robertwa1974/evScout--dash/enclosure/scout_dash_cutout_template.pdf

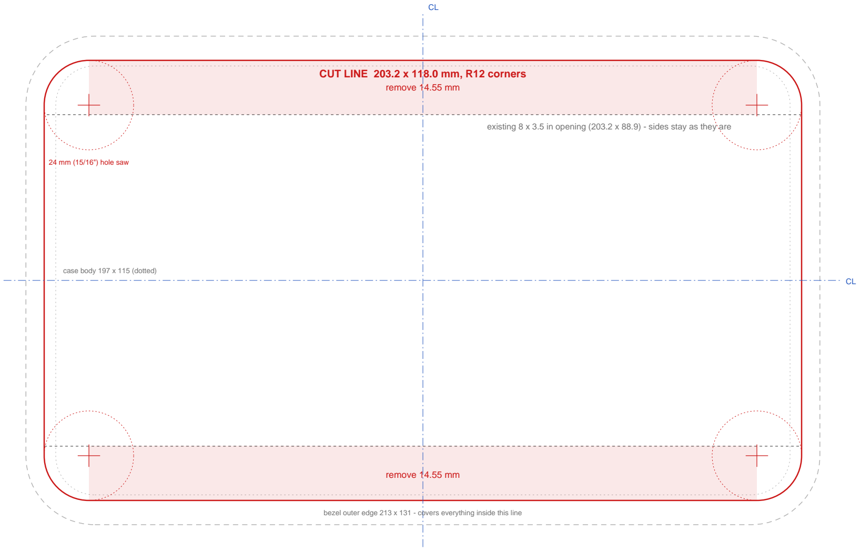
[picture p1: figure]
24 mm (15/16") hole saw; CUT LINE 203.2 x 118.0 mm, R12 corners remove 14.55 mm; remove 14.55 mm; case body 197 x 115 (dotted)

existing 8 x 3.5 in opening (203.2 x 88.9) - sides stay as they are

bezel outer edge 213 x 131 - covers everything inside this line

100 mm - measure this before cutting

4 in

# Scout 80 dash - Waveshare 7" cut-out template

PRINT AT 100% / ACTUAL SIZE (no 'fit to page'). Check both scale bars before cutting.

1 Tape the template to the dash face. Line up the grey dashed box with the existing opening edges. 2 Centre-punch the four + marks and cut the corners with a 24 mm (15/16") hole saw. 3 Cut straight between the holes along the red line, top and bottom only. File to the line and deburr. 4 Test-fit the case: it should slide in with ~3 mm side play and ~1.5 mm top/bottom; the bezel hides the gap.

Assumes the new opening is centred vertically on the existing one. Shift the template if you want it elsewhere.
