robertwa1974/evScout--dash/enclosure/box_v7_view.png

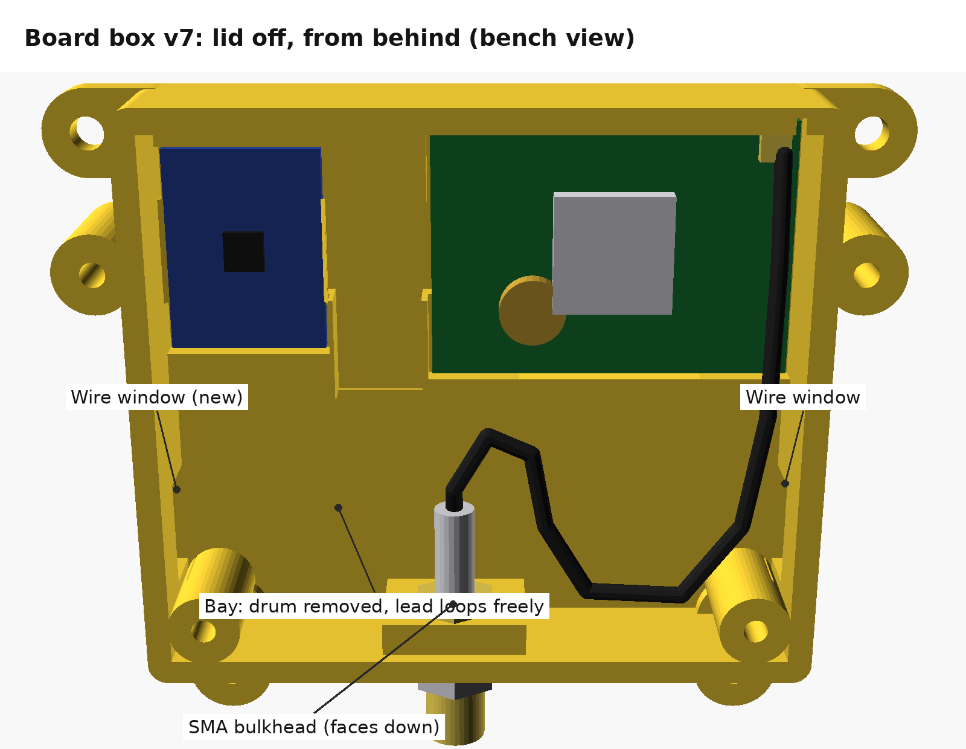
enclosure/box_v7_view.png
