robertwa1974/evScout--dash/enclosure/box_v8_view.png

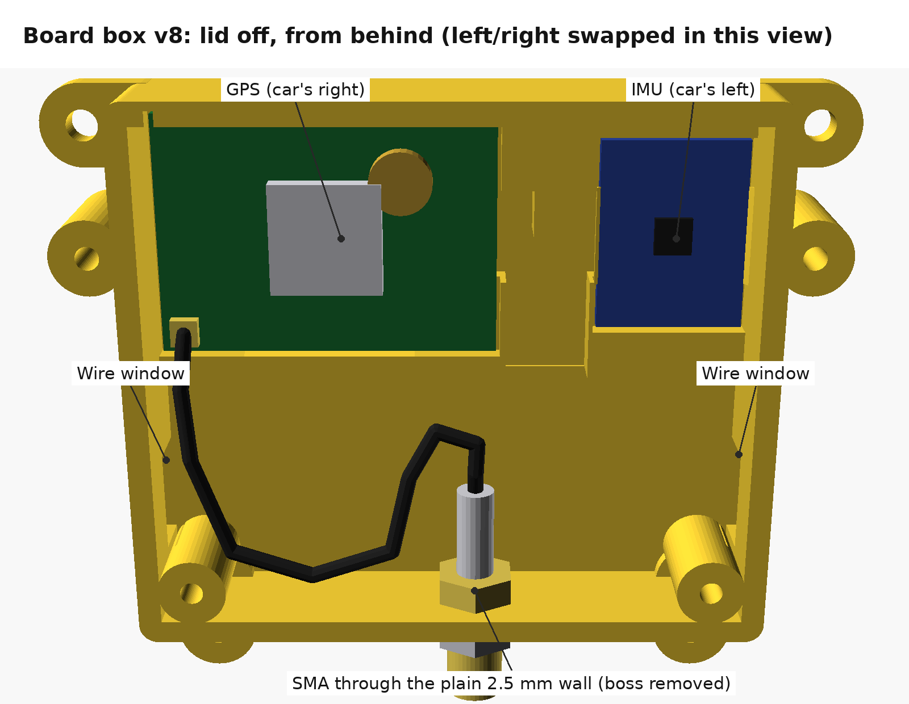
enclosure/box_v8_view.png
