robertwa1974/evScout--dash/enclosure/enclosure_views.png

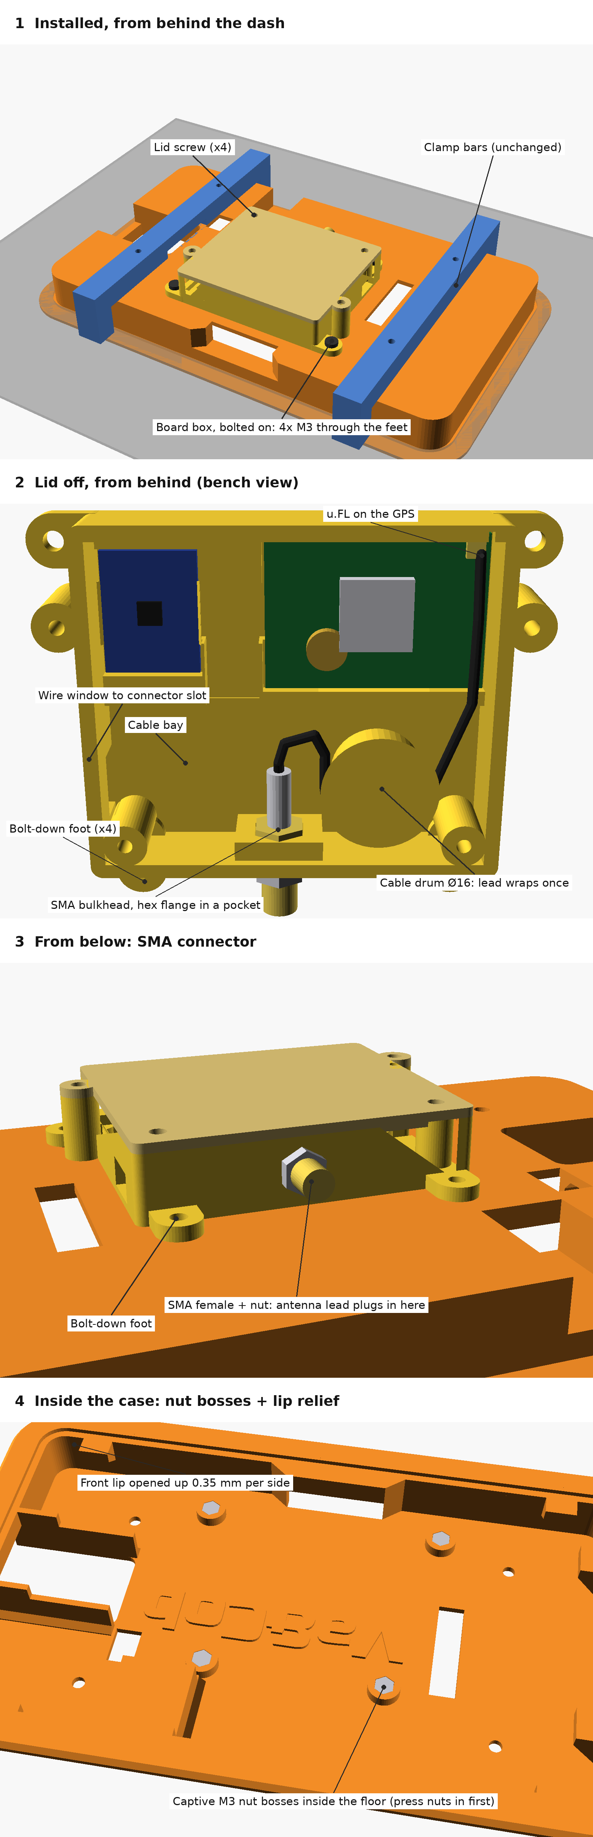
enclosure/enclosure_views.png
