robertwa1974/evScout--dash/enclosure/preview.png

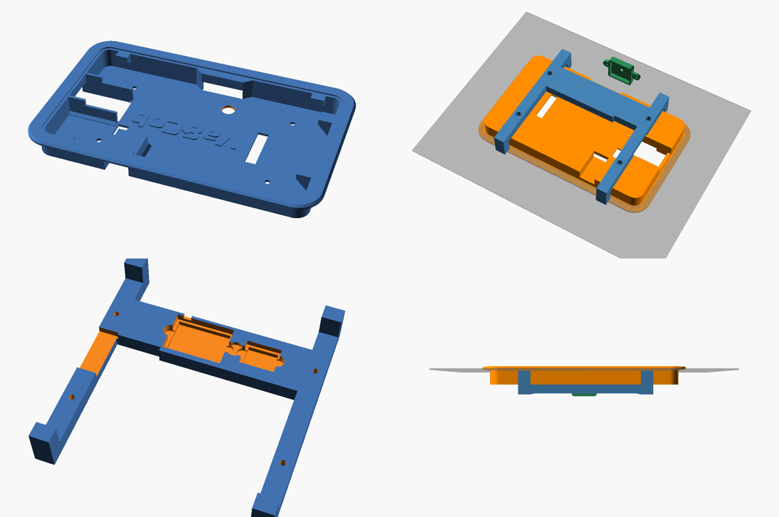
enclosure/preview.png
