robertwa1974/evScout--dash/firmware/assets/incline_art_preview.png

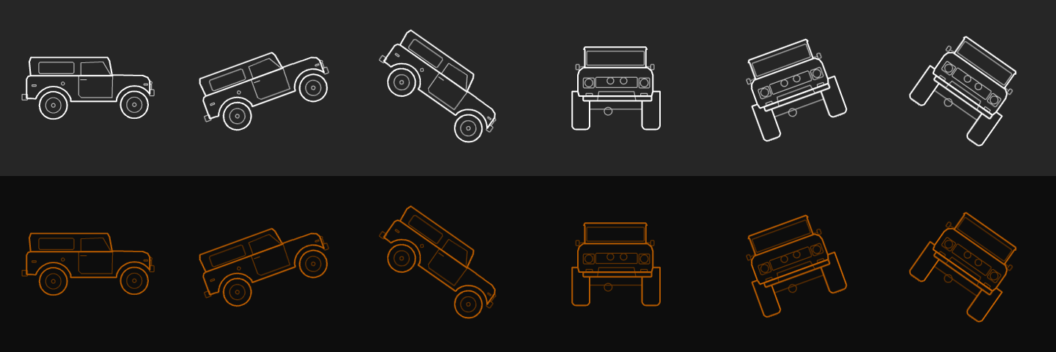
firmware/assets/incline_art_preview.png
