robertwa1974/evScout--dash/firmware/assets/SCOUT.png

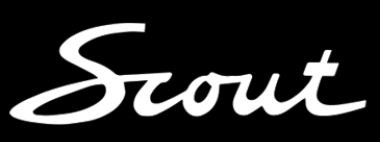
firmware/assets/SCOUT.png
