robertwa1974/evScout--dash/enclosure/scout_dash_board_box.stl

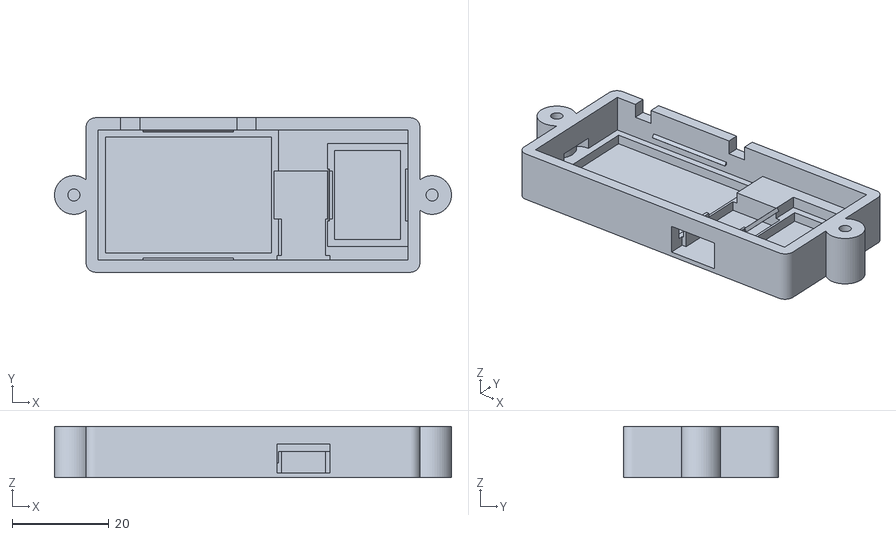
[picture p8: CAD file, 2026-10-24]
enclosure/scout_dash_board_box.stl
81.9 x 31.9 x 10.6
