robertwa1974/evScout--dash/enclosure/scout_dash_board_box_lid.stl

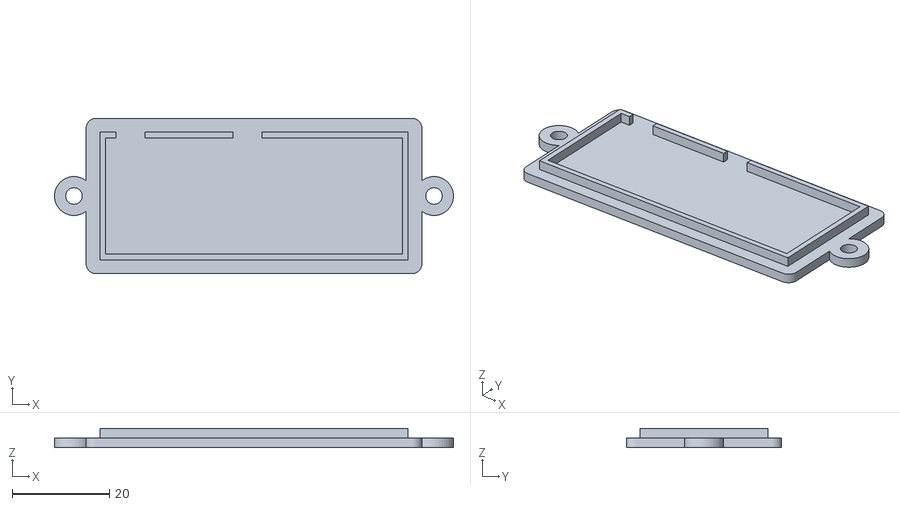
[picture p9: CAD file, 2026-10-24]
enclosure/scout_dash_board_box_lid.stl
81.9 x 31.9 x 4.00
