robertwa1974/evScout--dash/enclosure/scout_dash_board_tray.stl

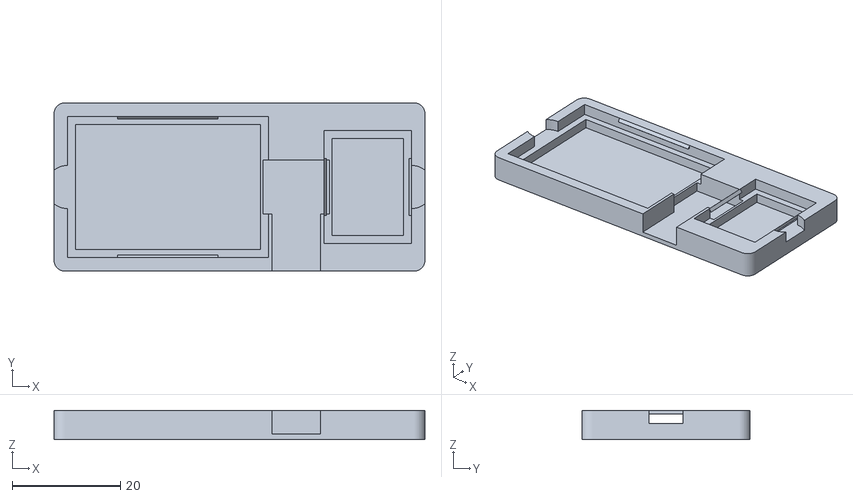
[picture p10: CAD file, 2026-10-24]
enclosure/scout_dash_board_tray.stl
68.7 x 31.1 x 5.40
