robertwa1974/evScout--dash/enclosure/scout_dash_clamp_bars_8mm_standoffs.stl

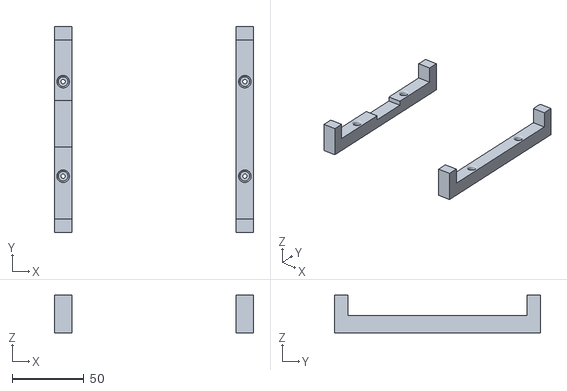
[picture p11: CAD file, 2026-10-24]
enclosure/scout_dash_clamp_bars_8mm_standoffs.stl
138.2 x 143.0 x 26.2
