robertwa1974/evScout--dash/enclosure/scout_dash_clamp_bars_6mm_standoffs.stl

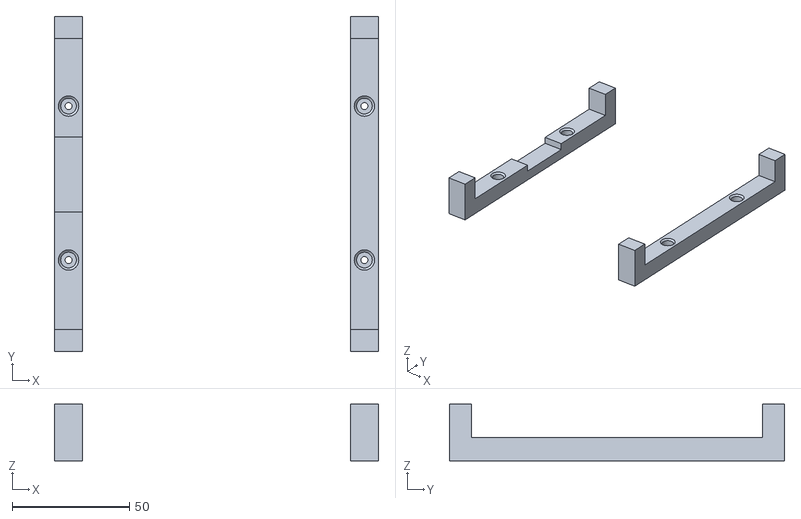
[picture p12: CAD file, 2026-10-24]
enclosure/scout_dash_clamp_bars_6mm_standoffs.stl
138.2 x 143.0 x 24.2
