robertwa1974/evScout--dash/enclosure/scout_dash_carrier_6mm_standoffs.stl

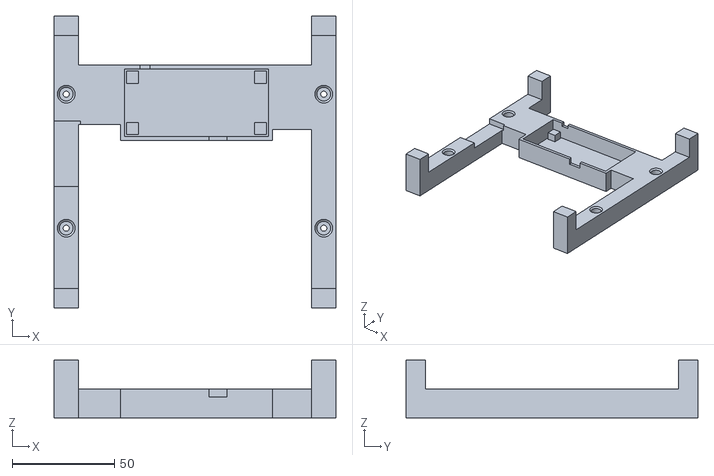
[picture p13: CAD file, 2026-10-24]
enclosure/scout_dash_carrier_6mm_standoffs.stl
138.2 x 143.0 x 28.4
