robertwa1974/evScout--dash/enclosure/scout_dash_case_flange.stl

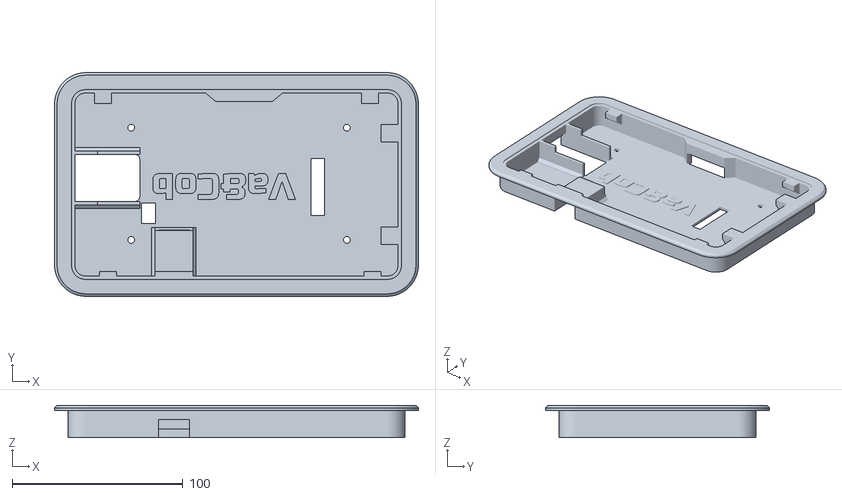
[picture p14: CAD file, 2026-10-24]
enclosure/scout_dash_case_flange.stl
213.0 x 131.0 x 19.0
