robertwa1974/evScout--dash/enclosure/scout_dash_gps_pod.stl

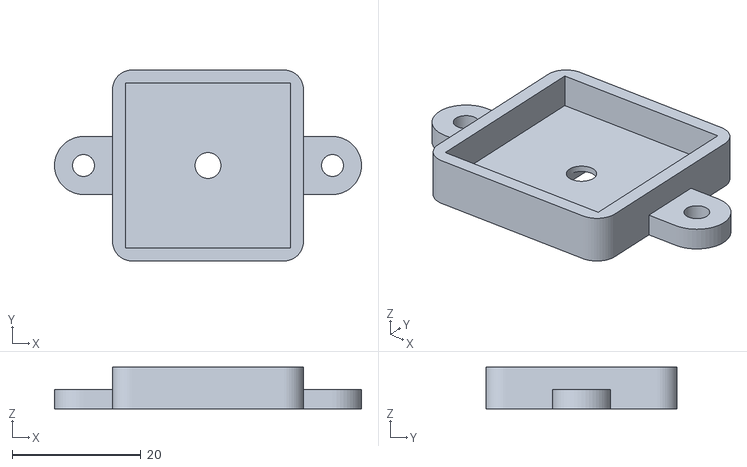
[picture p15: CAD file, 2026-10-12]
enclosure/scout_dash_gps_pod.stl
47.6 x 29.6 x 6.50
