robertwa1974/evScout--dash/enclosure/scout_dash_carrier.stl

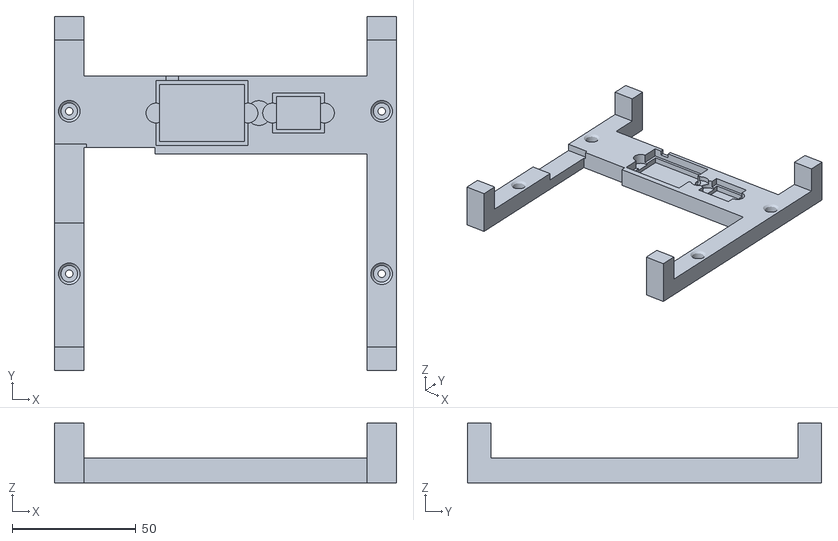
[picture p16: CAD file, 2026-10-12]
enclosure/scout_dash_carrier.stl
138.2 x 143.0 x 24.2
