robertwa1974/evScout--dash/(list of files, cad)

Other CAD files:
enclosure/scout_dash_carrier_8mm_standoffs.stl
