robertwa1974/evScout--dash/firmware/test/zombieverter_replay.csv

Time Stamp | ID | Extended | Dir | Bus | LEN | D1 | D2 | D3 | D4 | D5 | D6 | D7 | D8
0 | 0x00000126 | false | Rx | 0 | 8 | 00 | 00 | 00 | 00 | 2D | 00 | 00 | 00
1000 | 0x00000210 | false | Rx | 0 | 8 | 00 | 00 | 00 | 00 | 96 | 00 | 00 | 00
2000 | 0x00000257 | false | Rx | 0 | 8 | CE | 56 | 00 | 00 | 00 | 00 | 00 | 00
3000 | 0x00000300 | false | Rx | 0 | 8 | 02 | 00 | 00 | 00 | 00 | 00 | 00 | 00
4000 | 0x00000301 | false | Rx | 0 | 8 | 01 | 00 | 00 | 00 | 00 | 00 | 00 | 00
5000 | 0x00000302 | false | Rx | 0 | 8 | 4B | 00 | 00 | 00 | 00 | 00 | 00 | 00
6000 | 0x00000355 | false | Rx | 0 | 8 | 52 | 00 | 00 | 00 | 00 | 00 | 00 | 00
7000 | 0x00000356 | false | Rx | 0 | 8 | A0 | 0F | 2C | 02 | 26 | 00 | 00 | 00
100000 | 0x00000126 | false | Rx | 0 | 8 | 00 | 00 | 00 | 00 | 2D | 00 | 00 | 00
101000 | 0x00000210 | false | Rx | 0 | 8 | 00 | 00 | 00 | 00 | 96 | 00 | 00 | 00
102000 | 0x00000257 | false | Rx | 0 | 8 | CE | 56 | 00 | 00 | 00 | 00 | 00 | 00
103000 | 0x00000300 | false | Rx | 0 | 8 | 02 | 00 | 00 | 00 | 00 | 00 | 00 | 00
104000 | 0x00000301 | false | Rx | 0 | 8 | 01 | 00 | 00 | 00 | 00 | 00 | 00 | 00
105000 | 0x00000302 | false | Rx | 0 | 8 | 4B | 00 | 00 | 00 | 00 | 00 | 00 | 00
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
