robertwa1974/evScout--dash/firmware/src/display_driver.h

#pragma once

#include "config.h"
#include "lvgl.h"
#include "lv_conf.h"

// NOTE: ESP_IOExpander_Library is deliberately NOT included. Its CH422G C++
// wrapper pulls in ESP-IDF's new i2c_master ("driver_ng") API, which cannot
// coexist with the legacy driver/i2c.h API that LovyanGFX's Touch_GT911 uses on
// the same bus. The CH422G is driven directly from display_driver.cpp instead.

#define LGFX_USE_V1
#include <LovyanGFX.hpp>
#include <lgfx/v1/platforms/esp32s3/Panel_RGB.hpp>
#include <lgfx/v1/platforms/esp32s3/Bus_RGB.hpp>

// Board: Waveshare ESP32-S3-Touch-LCD-7 only. The upstream uaDASH fork
// also carried pin blocks for JC8048W550C, Waveshare 5" and Sunton 7"
// boards - removed 2026-10-23 (never built or tested in this project).
// WAVESHARE_S3_LCD7 is set in platformio.ini's build_flags.
#ifndef WAVESHARE_S3_LCD7
#error "This firmware only supports the Waveshare ESP32-S3-Touch-LCD-7 (-DWAVESHARE_S3_LCD7)"
#endif


#define LCD_PIN_BACKLIGHT   GPIO_NUM_6

// resolution
#define LCD_WIDTH   800U
#define LCD_HEIGHT   480U

#define LCD_PIN_HENABLE     GPIO_NUM_5
#define LCD_PIN_VSYNC       GPIO_NUM_3
#define LCD_PIN_HSYNC       GPIO_NUM_46
#define LCD_PIN_PCLK        GPIO_NUM_7

// RGB565 data pins
#define LCD_PIN_DATA_R0     GPIO_NUM_1
#define LCD_PIN_DATA_R1     GPIO_NUM_2
#define LCD_PIN_DATA_R2     GPIO_NUM_42
#define LCD_PIN_DATA_R3     GPIO_NUM_41
#define LCD_PIN_DATA_R4     GPIO_NUM_40
  
#define LCD_PIN_DATA_G0     GPIO_NUM_39
#define LCD_PIN_DATA_G1     GPIO_NUM_0
#define LCD_PIN_DATA_G2     GPIO_NUM_45
#define LCD_PIN_DATA_G3     GPIO_NUM_48
#define LCD_PIN_DATA_G4     GPIO_NUM_47
#define LCD_PIN_DATA_G5     GPIO_NUM_21

#define LCD_PIN_DATA_B0     GPIO_NUM_14
#define LCD_PIN_DATA_B1     GPIO_NUM_38
#define LCD_PIN_DATA_B2     GPIO_NUM_18
#define LCD_PIN_DATA_B3     GPIO_NUM_17
#define LCD_PIN_DATA_B4     GPIO_NUM_10

// timing and polarity
#define LCD_FREQ                14000000U
#define LCD_PCLK_ACTIVE_NEG     1
#define LCD_DE_IDLE_HIGH        1
#define LCD_PCLK_IDLE_HIGH      1

#define LCD_HSYNC_POLARITY      0
#define LCD_HSYNC_FRONT_PORCH   8
#define LCD_HSYNC_PULSE_WIDTH   4
#define LCD_HSYNC_BACK_PORCH    8

#define LCD_VSYNC_POLARITY      0
#define LCD_VSYNC_FRONT_PORCH   8
#define LCD_VSYNC_PULSE_WIDTH   4
#define LCD_VSYNC_BACK_PORCH    8

// touch
#define TOUCH_XMAX  LCD_WIDTH - 1
#define TOUCH_YMAX  LCD_HEIGHT - 1

#define TOUCH_PIN_INT   GPIO_NUM_NC
#define TOUCH_PIN_RST   GPIO_NUM_NC
#define TOUCH_PIN_SDA   GPIO_NUM_8
#define TOUCH_PIN_SCL   GPIO_NUM_9

#define TOUCH_FREQ      400000U
#define TOUCH_ROTATION  0

// WAVESHARE_S3_LCD7 end



class LCD_Panel : public lgfx::LGFX_Device {
  lgfx::Bus_RGB _bus_instance;
  lgfx::Touch_GT911 _touch_instance;
  lgfx::Panel_RGB _panel_instance;

  public: LCD_Panel(void);
};

extern LCD_Panel display;
extern int brightnessVal;

#ifdef __cplusplus
extern "C" {
#endif

void lcd_panel_start();

// Asserts SD_CS (CH422G bit4) permanently low - see sd_driver.h for why
// this is a one-time assert rather than a per-SPI-transaction toggle.
// Call once, after lcd_panel_start() (that brings up the I2C bus and puts
// the expander in output mode) and before sd_init().
void ch422g_assert_sd_cs(void);

void setBrightness(int val);
// Animated backlight fade (styling pass, 2026-09-18, item 11) - genuinely
// new, no existing fade primitive before this (setBrightness() above is an
// instant ledcWrite()). Used by the splash screen's boot-in ramp (Phase 4)
// and the low-12V shutdown fade-to-black (Phase 6). targetDuty is the raw
// 0-255 PWM duty (NOT clamped to setBrightness()'s 55 floor - shutdown
// needs to reach a real 0, fully off), ms is the ramp duration. Implemented
// via lv_anim_t stepping brightnessVal/ledcWrite over the window, same
// "own lv_anim_t targeting a plain value" pattern as
// ui_chargingScreen.c's battery-fill tween.
void backlight_rampTo(int targetDuty, uint32_t ms);
void disp_flush_callback(lv_disp_drv_t *disp, const lv_area_t *area, lv_color_t *px_map);
void touchpad_read(lv_indev_drv_t *indev_driver, lv_indev_data_t *data);

#ifdef __cplusplus
} /*extern "C"*/
#endif
