robertwa1974/evScout--dash/firmware/src/sd_driver.h

#pragma once

#include <stdbool.h>
#include <freertos/FreeRTOS.h>
#include <freertos/semphr.h>

// microSD card driver (2026-09-14, bring-up for the eventual offline map-
// tile screen - see ui_navScreen.h / waveshare-dash-build.md for why a
// real tile map is still blocked on real tile data, independent of this
// driver existing). Deliberately scoped to mount + basic file I/O only -
// no tile format or reading code yet, that's a follow-up once real map
// tiles exist to test against.
//
// Known SD card directory conventions in this project (each documented in
// full where it's actually consumed, this is just an index so they're not
// scattered with no way to find them from here):
//   /maps/Z{zoom}_r{row}_c{col}.nav  - NAV vector map tiles, see
//                                      nav_tile_format.h / CLAUDE.md's
//                                      "Map tile format" section.
//   /splash_frames/frame_00.bin..    - splash-screen truck-revolve
//                                      animation frames (LVGL raw
//                                      RGB565), see ui_splash_truck.h and
//                                      firmware/assets/
//                                      convert_splash_frames.py.
//   /logs/LOG0001.csv..              - telemetry CSV logs, see
//                                      data_logger.h (2026-10-21).
//   /can/CAN0001.csv..               - raw CAN captures, SavvyCAN CSV,
//                                      see can_capture.h (2026-10-22).
//
// Pin assignments confirmed against Waveshare's own official example
// (github.com/waveshareteam/ESP32-S3-Touch-LCD-7, examples/Arduino/
// examples/03_SD_Test), not guessed or reused from a different board:
//   SD_MOSI = GPIO11, SD_CLK = GPIO12, SD_MISO = GPIO13 (dedicated SPI3
//   bus, confirmed free - not used by this board's RGB/DPI display bus,
//   the CAN transceiver, or the I2C touch/CH422G/IMU bus).
//   SD_CS is NOT a direct GPIO - it's EXIO4 on the same CH422G I/O
//   expander this project already drives directly via lgfx::i2c (see
//   display_driver.cpp's ch422g_assert_sd_cs()), for the same reason the
//   CH422G library itself is avoided project-wide (i2c_master/legacy
//   driver conflict, see display_driver.h).
//
// SD_CS is asserted low ONCE at init and left low permanently, never
// toggled per SPI transaction - confirmed this is intentional in
// Waveshare's own demo (their code does the identical thing), because
// toggling a chip-select through an I2C-bus IO expander per SPI
// transaction would be far too slow for SPI timing anyway. Consequence:
// **nothing else may share this SPI bus** - there is no way to deselect
// the SD card once sd_init() runs. Nothing else currently uses GPIO11/12/
// 13, and no other SPI device exists on this board's design, so this is
// safe today - but any future SPI peripheral MUST use a different bus.
//
// SD/SPI are both bundled with the arduino-esp32 core (no platformio.ini
// lib_deps entry needed - same as Preferences/WiFi elsewhere in this
// project).

// Guards every actual SD.open()/File::read()/seek()/close() call, wherever
// it happens - the truck-revolve splash animation (2026-09-19) introduced
// the first case of two different FreeRTOS tasks touching the card at
// once: ui_splash_truck.cpp's background preload task, and lv_fs_sd.cpp's
// registered LVGL fs driver (called from whichever task is running the
// LVGL timer when a frame falls back to an on-demand SD read - see
// ui_splash_truck.h). SD_CS is asserted once and left permanently low
// (see this header's own comment below), so unlike a normal SPI device
// there's no way to even electrically arbitrate between two callers - the
// SD card protocol's own multi-step command/response/data sequences must
// never be allowed to interleave between two tasks, which the ESP-IDF SPI
// driver's own per-transaction locking does NOT protect against (it only
// keeps individual transactions from tearing, not multi-transaction
// logical operations like a single File::read() call). Every SD-touching
// call site takes this before the operation and gives it back
// immediately after - callers should treat any single open/seek/read/
// close call as its own critical section, not something to hold the
// mutex across for longer than one such call.
extern SemaphoreHandle_t sdMutex;

#ifdef __cplusplus
extern "C" {
#endif

// Asserts SD_CS via the CH422G, brings up the dedicated SPI bus, and
// mounts the card. Call once at boot, AFTER lcd_panel_start() (needs the
// I2C/CH422G bus already up) - order relative to imu_init()/gps_init()
// doesn't matter, they're independent buses. Returns false if no card is
// inserted or it fails to mount (not a crash - a car dashboard can't
// assume a card is always present). Safe to call even with no card; every
// other sd_* function checks sd_available() internally rather than
// assuming success.
bool sd_init(void);

// Cached result of the last sd_init() call - check this before attempting
// any file I/O once real map-tile reading code is added.
bool sd_available(void);

#ifdef __cplusplus
}
#endif
