robertwa1974/evScout--dash/firmware/src/wifi_pages.h

#pragma once

// Static markup for the WiFi hotspot's pages (2026-10-23 restyle) - kept out
// of wifi_config_server.cpp so that file stays about request handling.
//
// Everything is inline/self-hosted: a phone on Scout80-Config has NO internet
// (CLAUDE.md -> Networking), so no web fonts, CDNs or external icons - system
// font stack only. Colors are the dash's own day palette (ui_theme.cpp), so
// the phone pages look like the dash.
//
// STYLE_CSS is served once at /style.css with a long cache lifetime; every
// page links it rather than repeating it.

static const char STYLE_CSS[] =
    ":root{--bg:#1a1a1a;--panel:#262626;--line:#444;--line2:#333;--text:#fff;--muted:#b0b0b0;"
    "--dim:#6b6b6b;--accent:#00d9ff;--good:#34c759;--warn:#ff3b30;--bad:#ff9500}"
    "*{box-sizing:border-box}"
    "body{margin:0;background:var(--bg);color:var(--text);"
    "font:16px/1.45 system-ui,-apple-system,'Segoe UI',Roboto,sans-serif;-webkit-text-size-adjust:100%}"
    "header{position:sticky;top:0;z-index:2;display:flex;align-items:center;gap:12px;flex-wrap:wrap;"
    "padding:10px 16px;background:#111;border-bottom:1px solid var(--line)}"
    ".brand{font-weight:800;letter-spacing:.14em;font-size:15px}.brand b{color:var(--accent)}"
    "nav{display:flex;gap:4px;margin-left:auto}"
    "nav a{color:var(--muted);text-decoration:none;padding:8px 14px;border-radius:9px;font-weight:700;font-size:15px}"
    "nav a.on{color:#000;background:var(--accent)}"
    "main{max-width:960px;margin:0 auto;padding:16px}"
    "h1{font-size:24px;margin:4px 0 16px}"
    "h2{font-size:13px;letter-spacing:.12em;text-transform:uppercase;color:var(--muted);margin:0 0 10px}"
    ".card{background:var(--panel);border:1px solid var(--line);border-radius:14px;padding:16px;margin-bottom:16px}"
    ".banner{border-radius:12px;padding:12px 16px;margin-bottom:16px;font-weight:700}"
    ".banner.ok{background:rgba(52,199,89,.14);color:var(--good);border:1px solid var(--good)}"
    ".banner.warn{background:rgba(255,59,48,.12);color:var(--warn);border:1px solid var(--warn)}"
    ".field{display:grid;grid-template-columns:1fr auto;gap:2px 14px;align-items:center;padding:12px 0;"
    "border-top:1px solid var(--line2)}"
    ".field:first-of-type{border-top:0;padding-top:4px}"
    ".field label{font-weight:700}.field small{color:var(--muted);grid-column:1}"
    ".inp{display:flex;align-items:center;gap:8px;grid-row:1/3;grid-column:2}"
    "input[type=number]{width:10em;padding:11px 12px;border-radius:10px;border:1px solid var(--line);"
    "background:#111;color:var(--text);font:inherit;font-variant-numeric:tabular-nums;text-align:right}"
    "input:focus{outline:2px solid var(--accent);border-color:transparent}"
    ".unit{color:var(--muted);min-width:2.6em;font-weight:600}"
    ".btn{display:inline-block;border:0;border-radius:10px;padding:12px 18px;font:inherit;font-weight:800;"
    "cursor:pointer;text-decoration:none;text-align:center;color:var(--text);background:#333}"
    ".btn.primary{background:var(--accent);color:#000;width:100%;padding:16px;font-size:18px}"
    ".btn.sm{padding:9px 14px;font-size:14px}"
    ".btn.danger{background:transparent;color:var(--warn);border:1px solid var(--warn)}"
    ".grid{display:grid;grid-template-columns:repeat(auto-fill,minmax(150px,1fr));gap:10px}"
    ".tile{background:#1f1f1f;border:1px solid var(--line2);border-radius:12px;padding:12px 14px}"
    ".tile .k{font-size:12px;letter-spacing:.09em;text-transform:uppercase;color:var(--muted);font-weight:700}"
    ".tile .v{font-size:30px;font-weight:800;margin-top:2px;font-variant-numeric:tabular-nums;white-space:nowrap}"
    ".tile .v small{font-size:14px;font-weight:700;color:var(--muted);margin-left:4px}"
    ".tile.wide{grid-column:span 2}"
    ".bar{height:8px;border-radius:4px;background:#111;margin-top:8px;overflow:hidden}"
    ".bar i{display:block;height:100%;width:0;background:var(--good);transition:width .4s}"
    ".pill{display:inline-flex;align-items:center;gap:7px;padding:6px 12px;border-radius:999px;font-size:14px;"
    "font-weight:800;background:#333;color:var(--muted)}"
    ".pill:before{content:'';width:8px;height:8px;border-radius:50%;background:currentColor}"
    ".pill.ok{color:var(--good);background:rgba(52,199,89,.13)}"
    ".pill.warn{color:var(--warn);background:rgba(255,59,48,.13)}"
    ".bar-row{display:flex;align-items:center;gap:12px;flex-wrap:wrap;margin-bottom:16px}"
    ".hint{color:var(--muted);font-size:14px}"
    ".is-warn{color:var(--warn)!important}.is-dim{color:var(--dim)!important}"
    "table{width:100%;border-collapse:collapse}"
    "td{padding:12px 6px;border-top:1px solid var(--line2);vertical-align:middle}"
    "tr:first-child td{border-top:0}"
    "td.name{font-weight:800;font-family:ui-monospace,Menlo,Consolas,monospace}"
    "td.size{color:var(--muted);white-space:nowrap;font-variant-numeric:tabular-nums}"
    "td.act{text-align:right;white-space:nowrap}td.act form{display:inline;margin-left:6px}"
    ".badge{display:inline-block;padding:5px 9px;border-radius:7px;font-size:12px;font-weight:800;"
    "letter-spacing:.06em;background:rgba(255,59,48,.15);color:var(--warn)}"
    ".empty{color:var(--muted);margin:0}"
    "footer{max-width:960px;margin:0 auto;padding:4px 16px 32px;color:var(--dim);font-size:13px}"
    "@media(max-width:560px){.field{grid-template-columns:1fr}.inp{grid-row:auto;grid-column:1;width:100%}"
    "input[type=number]{width:100%}.tile .v{font-size:26px}.tile.wide{grid-column:span 1}"
    "nav{margin-left:0;width:100%}nav a{flex:1;text-align:center}}";

// /update body (2026-10-24): pick firmware.bin, upload with a progress bar
// (XHR, so upload progress is visible), then wait for the reboot and show
// the new version from /api/version.
static const char UPDATE_BODY[] =
    "<div class='card'><h2>Install firmware over WiFi</h2>"
    "<p class='hint'>Use <b>firmware.bin</b> from a release - not the merged image. "
    "Settings, odometer and logs are kept. The dash reboots when it's done.</p>"
    "<div class='field'><label for='fw'>Firmware file</label>"
    "<div class='inp'><input type='file' id='fw' accept='.bin'></div></div>"
    "<div class='bar' style='height:12px;margin:8px 0 14px'><i id='pb'></i></div>"
    "<p id='msg' class='hint'></p>"
    "<button id='go' class='btn primary' type='button'>Install</button></div>"
    "<script>"
    "const $=i=>document.getElementById(i);"
    "function say(t,w){const m=$('msg');m.textContent=t;m.className=w?'hint is-warn':'hint';}"
    "function waitBack(){fetch('/api/version',{cache:'no-store'}).then(r=>r.json()).then(v=>{"
    "say('Done - now running '+v.version+'.');$('go').disabled=false;"
    "}).catch(()=>setTimeout(waitBack,2000));}"
    "$('go').onclick=()=>{const f=$('fw').files[0];"
    "if(!f){say('Choose a firmware.bin file first.',1);return;}"
    "if(/merged/i.test(f.name)){say('That is the merged image - use firmware.bin for WiFi updates.',1);return;}"
    "const fd=new FormData();fd.append('firmware',f,f.name);"
    "const x=new XMLHttpRequest();x.open('POST','/update');"
    "x.upload.onprogress=e=>{if(e.lengthComputable){const p=Math.round(e.loaded*100/e.total);"
    "$('pb').style.width=p+'%';say('Uploading '+p+'%');}};"
    "x.onload=()=>{if(x.status==200){$('pb').style.width='100%';"
    "say('Installed - rebooting. Reconnect to Scout80-Config if your phone drops off.');"
    "setTimeout(waitBack,8000);}else{say(x.responseText||'Update failed',1);$('go').disabled=false;}};"
    "x.onerror=()=>{say('Upload failed - is the phone still on Scout80-Config?',1);$('go').disabled=false;};"
    "$('go').disabled=true;say('Uploading 0%');x.send(fd);};"
    "</script>";

// /live body - filled in by the script from /api/live once a second. Each
// value element's FIRST child is a text node the script overwrites, so the
// unit <small> after it stays put.
static const char LIVE_BODY[] =
    "<div class='bar-row'><span id='st' class='pill'>Connecting&hellip;</span>"
    "<span id='age' class='hint'></span></div>"
    "<div class='card'><h2>Drive</h2><div class='grid'>"
    "<div class='tile'><div class='k'>Speed</div><div class='v' id='veh_mph'>--<small>mph</small></div></div>"
    "<div class='tile'><div class='k'>Power</div><div class='v' id='power_kw'>--<small>kW</small></div></div>"
    "<div class='tile'><div class='k'>Motor</div><div class='v' id='motor_rpm'>--<small>rpm</small></div></div>"
    "<div class='tile'><div class='k'>Op mode</div><div class='v' id='opmode'>--</div></div>"
    "</div></div>"
    "<div class='card'><h2>Efficiency</h2><div class='grid'>"
    "<div class='tile'><div class='k'>Range</div><div class='v' id='range_mi'>--<small>mi</small></div></div>"
    "<div class='tile'><div class='k'>Trip</div><div class='v' id='trip_whmi'>--<small>Wh/mi</small></div></div>"
    "<div class='tile'><div class='k'>Last ~10 mi</div><div class='v' id='recent_whmi'>--<small>Wh/mi</small></div></div>"
    "</div></div>"
    "<div class='card'><h2>Battery</h2><div class='grid'>"
    "<div class='tile'><div class='k'>State of charge</div><div class='v' id='soc'>--<small>%</small></div>"
    "<div class='bar'><i id='socbar'></i></div></div>"
    "<div class='tile'><div class='k'>Pack voltage</div><div class='v' id='pack_v'>--<small>V</small></div></div>"
    "<div class='tile'><div class='k'>Pack current</div><div class='v' id='pack_a'>--<small>A</small></div></div>"
    "<div class='tile'><div class='k'>Cell min / max</div><div class='v' id='cells'>--<small>V</small></div></div>"
    "<div class='tile'><div class='k'>Cell spread</div><div class='v' id='celld'>--<small>mV</small></div></div>"
    "<div class='tile'><div class='k'>Cell temp max</div><div class='v' id='cell_tmax'>--<small>&deg;C</small></div></div>"
    "</div></div>"
    "<div class='card'><h2>Temperatures</h2><div class='grid'>"
    "<div class='tile'><div class='k'>Inverter</div><div class='v' id='inverter_c'>--<small>&deg;C</small></div></div>"
    "<div class='tile'><div class='k'>Motor</div><div class='v' id='motor_c'>--<small>&deg;C</small></div></div>"
    "</div></div>"
    "<div class='card'><h2>System</h2><div class='grid'>"
    "<div class='tile'><div class='k'>12V aux</div><div class='v' id='aux_v'>--<small>V</small></div></div>"
    "<div class='tile'><div class='k'>Last error</div><div class='v' id='last_err'>--</div></div>"
    "<div class='tile'><div class='k'>Odometer</div><div class='v' id='odo_mi'>--<small>mi</small></div></div>"
    "<div class='tile'><div class='k'>Trip</div><div class='v' id='trip_mi'>--<small>mi</small></div></div>"
    "<div class='tile'><div class='k'>GPS</div><div class='v' id='gps'>--</div></div>"
    "<div class='tile'><div class='k'>Logging</div><div class='v' id='logging'>--</div></div>"
    "</div></div>"
    "<script>"
    "const $=i=>document.getElementById(i);let last=0;"
    "function put(i,v){const e=$(i);if(e)e.firstChild.nodeValue=v;}"
    "function num(v,d){return(typeof v==='number'&&isFinite(v))?v.toFixed(d):'--';}"
    "function pos(v){return(typeof v==='number'&&v>=0)?v.toFixed(0):'--';}"
    "function flag(i,w,dim){const e=$(i);if(!e)return;e.classList.toggle('is-warn',!!w);e.classList.toggle('is-dim',!!dim);}"
    "async function tick(){try{"
    "const d=await(await fetch('/api/live',{cache:'no-store'})).json();last=Date.now();"
    "const s=$('st');s.className='pill '+(d.can_live?'ok':'');s.textContent=d.can_live?'CAN live':'No CAN data';"
    "const nd=!d.can_live;"
    "put('veh_mph',num(d.veh_mph,0));put('power_kw',num(d.power_kw,1));put('motor_rpm',num(d.motor_rpm,0));"
    "put('opmode',d.opmode);put('soc',num(d.soc,0));put('pack_v',num(d.pack_v,1));put('pack_a',num(d.pack_a,1));"
    "put('cells',num(d.cell_vmin,2)+' / '+num(d.cell_vmax,2));"
    "put('celld',num((d.cell_vmax-d.cell_vmin)*1000,0));put('cell_tmax',num(d.cell_tmax,0));"
    "put('inverter_c',num(d.inverter_c,0));put('motor_c',num(d.motor_c,0));put('aux_v',num(d.aux_v,2));"
    "put('last_err',d.last_err?String(d.last_err):'None');put('odo_mi',num(d.odo_mi,1));put('trip_mi',num(d.trip_mi,1));"
    "put('gps',d.gps_fix?(d.gps_sats+' sats'):'No fix');put('logging',d.logging==='off'?'Off':d.logging);"
    "put('range_mi',pos(d.range_mi));put('trip_whmi',pos(d.trip_whmi));put('recent_whmi',pos(d.recent_whmi));"
    "const b=$('socbar');b.style.width=Math.max(0,Math.min(100,d.soc))+'%';"
    "b.style.background=d.soc<=15?'var(--warn)':'var(--good)';"
    "flag('last_err',d.last_err,false);flag('gps',false,!d.gps_fix);"
    "['veh_mph','power_kw','motor_rpm','opmode','soc','pack_v','pack_a','cells','celld','cell_tmax',"
    "'inverter_c','motor_c','aux_v'].forEach(i=>flag(i,false,nd));"
    "}catch(e){const s=$('st');s.className='pill warn';s.textContent='Dash not reachable';}}"
    "setInterval(()=>{if(last)$('age').textContent='Updated '+Math.round((Date.now()-last)/1000)+' s ago';},1000);"
    "tick();setInterval(tick,1000);"
    "</script>";
