robertwa1974/evScout--dash/firmware/src/config.h

#ifndef DISPLAY_CONFIG_H
#define DISPLAY_CONFIG_H

// #define DEBUG
// Board selection moved to platformio.ini (-DWAVESHARE_S3_LCD7) - the
// upstream multi-board menu that lived here was removed 2026-10-23.



#endif  // HEADER
