robertwa1974/evScout--dash/firmware/src/can_sdo.h

#pragma once

#include <Arduino.h>
#include "twai_lib.h"

// ============================================================================
// CANopen SDO client for ZombieVerter VCU
// ============================================================================
// Confirmed against Rob's own working SDOManager.cpp (Dial firmware) -
// this is a direct port of that encoding, not an inferred one.
// ============================================================================

// --- Node/COB-ID config -----------------------------------------------------
// ZOMBIE_NODE_ID is the CANopen node ID of the *VCU we are querying*, not this
// dash. An SDO client has no node ID of its own. The ZombieVerter is node 3
// (confirmed on Rob's bus), so requests go to 0x603 and responses come back on
// 0x583. Change this only if the VCU's node ID is reconfigured.
#define ZOMBIE_NODE_ID      3
#define SDO_TX_COBID        (0x600 + ZOMBIE_NODE_ID)   // request -> VCU (0x603)
#define SDO_RX_COBID        (0x580 + ZOMBIE_NODE_ID)   // response <- VCU (0x583)

// ZombieVerter folds a flat 16-bit param ID into CANopen's two-field
// (16-bit index + 8-bit subindex) addressing:
//   index    = SDO_BASE_INDEX | (paramId >> 8)
//   subindex = paramId & 0xFF
// This holds for the full ID range (1-255 legacy params and 2000+ spot
// telemetry values alike) - pure bit arithmetic, confirmed working in
// the Dial firmware's SDOManager.
#define SDO_BASE_INDEX      0x2100

// SDO command bytes (CANopen standard)
#define SDO_CMD_READ_REQ    0x40   // upload request (dash -> VCU)
#define SDO_CMD_WRITE_REQ   0x23   // expedited download request, 4 data bytes
#define SDO_CMD_RESP_4BYTE  0x43   // expedited upload response, 4 data bytes
#define SDO_CMD_RESP_2BYTE  0x4B   // expedited upload response, 2 data bytes
#define SDO_CMD_RESP_1BYTE  0x4F   // expedited upload response, 1 data byte
#define SDO_CMD_WRITE_ACK   0x60   // expedited download response (success)
#define SDO_CMD_ABORT       0x80   // error/abort response

// libopeninv's command object (sdocommands.cpp): an expedited write to
// index 0x5002 runs the command named by the subindex. Only SAVE is used
// here (persist the VCU's current params to its own flash) - the same
// thing the openinverter web UI's "Save parameters to flash" button sends.
// Verified on Rob's ZombieVerter 2026-10-23: a saved param survives a VCU
// restart.
#define SDO_INDEX_COMMANDS  0x5002
#define SDO_SUBCMD_SAVE     0

// Standard CANopen abort codes the VCU actually returns (bytes 4-7 of an
// 0x80 abort frame).
#define SDO_ABORT_NO_OBJECT 0x06020000UL  // param ID doesn't exist on this firmware
#define SDO_ABORT_RANGE     0x06090030UL  // written value outside the param's min/max

// OpenInverter fixed-point scale: most params are stored as value * 32.
// TODO: confirm this against your Dial firmware - not all params
// necessarily use the same scale factor.
#define OI_FIXED_POINT_SCALE 32.0f

// --- Public API --------------------------------------------------------------

extern ESP32S3_TWAI can;

// Send an SDO read (upload) request for the given parameter ID.
// Non-blocking - the response arrives later via the receive loop.
bool sdoRequestRead(uint16_t paramId);

// Send an SDO write (download) request for the given parameter ID,
// with value already converted to the VCU's fixed-point integer format
// (e.g. call sdoWrite(25, (int32_t)(realValue * OI_FIXED_POINT_SCALE))).
bool sdoWrite(uint16_t paramId, int32_t rawValue);

// Parse a raw CAN frame that arrived on SDO_RX_COBID. If it's a valid
// read-response, fills outParamId and outValue and returns true.
bool sdoParseResponse(const uint8_t *data, uint8_t length,
                       uint16_t *outParamId, int32_t *outValue);

// Expedited write to an arbitrary index/subindex - sdoWrite() above is this
// with the param-UID addressing applied. Used for SDO_INDEX_COMMANDS.
bool sdoWriteRaw(uint16_t index, uint8_t subindex, int32_t rawValue);

// Superset of sdoParseResponse(): also classifies write acks and aborts,
// which sdo_client.h needs to track write/save outcomes. outValue is the
// read value for SDO_RESULT_VALUE, the abort code for SDO_RESULT_ABORT, and
// untouched otherwise. outIndex/outSubindex are the raw CANopen address the
// VCU echoed back - see sdoIndexIsParam()/sdoParamIdFromIndex().
typedef enum {
    SDO_RESULT_INVALID,    // too short / unrecognized command byte
    SDO_RESULT_VALUE,      // expedited upload (read) response
    SDO_RESULT_WRITE_ACK,  // expedited download (write) succeeded
    SDO_RESULT_ABORT,      // VCU rejected the request
} SdoResult;

SdoResult sdoParseResponseEx(const uint8_t *data, uint8_t length,
                             uint16_t *outIndex, uint8_t *outSubindex, int32_t *outValue);

inline bool sdoIndexIsParam(uint16_t index) {
    return (index & 0xFF00) == SDO_BASE_INDEX;
}

inline uint16_t sdoParamIdFromIndex(uint16_t index, uint8_t subindex) {
    return (uint16_t)(((index & 0xFF) << 8) | subindex);
}

inline float sdoToFloat(int32_t rawValue) {
    return (float)rawValue / OI_FIXED_POINT_SCALE;
}
