robertwa1974/evScout--dash/firmware/src/graph_loader.h

// graph_loader.h - ROUTE.bin paged graph loader with on-demand PSRAM
// cache, ported from jgauchia/IceNav-v3 (lib/router/src/graph_loader.hpp,
// pinned tag v.0.2.9, commit d1819b771e12394e185cdf18e8a14875b0998912).
// Class/method names and the LRU page-cache algorithm are unchanged from
// upstream. See graph_loader.cpp's header comment for what was adapted
// and why (SD access layer, routeSpeed parameter).
//
// ONE deviation from upstream's own struct layout: cellIndex_ below uses
// PsramAllocator, upstream (and this port, until 2026-09-16) used the
// plain default allocator (internal SRAM). That's fine for a country/
// region-sized extract like upstream's own test data, but a whole-state
// ROUTE.bin (California CAR profile: 15928 cells x 20 bytes =~ 311KB)
// exhausted internal heap already under pressure from LVGL's double draw
// buffers, WiFi/BT, and task stacks, and crashed on real hardware.
// PSRAM (8MB via board_build.psram_type=opi) has ample room - moved
// cellIndex_ there, matching PageData's nodes/edges below.
#pragma once
#include <cstdint>
#include <vector>
#include <unordered_map>
#include <SD.h>
#include "route_types.h"
#include "psram_allocator.h"

static constexpr uint32_t MAX_EDGES_PER_NODE_GL = 64;

// Maximum number of pages (subcells) to keep in PSRAM cache simultaneously.
// Each page holds nodes + edges for one 0.1x0.1 degree cell. At ~1MB free
// PSRAM and ~10-20KB/page average, 48 pages ~= 500-960KB.
static constexpr uint32_t PAGE_CACHE_MAX = 48;

class GraphLoader {
public:
    bool load(uint16_t routeSpeed);
    void unload();
    bool isLoaded() const { return loaded_; }

    uint32_t nearestNode(float lat, float lon) const;
    bool getNode(uint32_t gi, RouteNode &out_node) const;
    bool getEdgesForNode(uint32_t gi, RouteEdge *buf, uint32_t &count) const;
    uint32_t totalNodes() const { return totalNodes_; }
    void preloadPoint(float lat, float lon) const;

private:
    struct PageData {
        std::vector<RouteNode, PsramAllocator<RouteNode>> nodes;
        std::vector<RouteEdge, PsramAllocator<RouteEdge>> edges;
        uint32_t cell_idx;    // index into cellIndex_
        uint32_t lru_stamp;   // incremented on each access
    };

    using PageMap = std::unordered_map<uint32_t, PageData,
                        std::hash<uint32_t>, std::equal_to<uint32_t>,
                        PsramAllocator<std::pair<const uint32_t, PageData>>>;

    std::vector<CellIndexEntry, PsramAllocator<CellIndexEntry>> cellIndex_;
    mutable PageMap pageCache_;
    mutable uint32_t lru_clock_ = 0;

    mutable File file_;
    bool fileOpen_ = false;
    uint32_t data_base_offset_ = 0;  // byte offset in file where cell data blocks start
    uint32_t totalNodes_ = 0;
    bool loaded_ = false;

    // Returns cell index for the global node gi, or UINT32_MAX if not found.
    uint32_t cellForNode(uint32_t gi) const;

    // Ensures the page for cell_idx is loaded in pageCache_. Returns pointer or nullptr.
    PageData *fetchPage(uint32_t cell_idx) const;

    // Evict the least-recently-used page.
    void evictLRU() const;
};

extern GraphLoader graphLoader;
