robertwa1974/evScout--dash/firmware/src/ui_navScreen.cpp

// ============================================================================
// ui_navScreen.cpp - GPS NAV: offline map + turn-by-turn navigation
// ============================================================================
// See ui_navScreen.h for the component-5 rebuild history and why this is
// now .cpp. Layout, top to bottom: thin top status bar (time, SOC%), map
// canvas (single NAV tile's filled geometry + route line + turn banner
// overlay + "you are here" dot), bottom telemetry strip (fix status/
// speed/heading, then ETA/distance-remaining/swipe-position-dots).
//
// Projection: local flat-earth approximation, recomputed from scratch
// against the CURRENT (latest) fix every update, not the trail's start
// point - this is what keeps "you are here" pinned to canvas center as the
// vehicle moves. Standard equirectangular approximation (good to well
// under 1% error at the few-km scale this screen covers - the same
// "simple, sanity-checked, not aerospace-grade" bar already applied to the
// sunrise/solar-declination calc elsewhere in this project):
//   metersNorth = (lat - curLat) * 111320
//   metersEast  = (lon - curLon) * 111320 * cos(curLat in radians)
// 111320 = meters per degree of latitude, effectively constant at driving
// latitudes (varies <1% pole-to-equator) - good enough here, not orbital
// mechanics. The route line and turn-banner distance math (gps_math.h/
// nav_turn.h) use real Haversine distance instead - only the on-screen
// pixel projection uses this flat-earth shortcut.
//
// Routing (scope narrowed 2026-09-16 from "general nav" to a small fixed
// destination set, EXTENDED 2026-09-22 from Home-only to Home/Work/nearest
// charging station): a full destination-entry UI (address search, long-
// press-to-set) is real scope this project isn't taking on - the actual,
// explicitly requested feature is picking from a small, fixed list of
// named destinations (see ui_destinationsScreen.h), not navigation to
// anywhere. This is a real simplification, not a placeholder: no
// destination search UI is planned, ever. Destination PICKING lives on
// ui_destinationsScreen.cpp now; this file just owns the routing
// computation itself, button-TRIGGERED via ui_navScreen_requestRoute()
// (called from that screen's row-tap handler), never automatic on screen
// open. Router::route() needs a real ROUTE.bin (CAR profile) on the SD
// card to succeed - if that file doesn't exist yet, routing fails
// gracefully (RouterResult != OK) and the turn banner shows "SELECT
// DESTINATION" (was "PRESS HOME" before the Home-only button was
// replaced), same "false is fine, just means nothing there" convention
// nav_tile_load() already uses.
//
// No SquareLine project (same as every other hand-written screen here).
//
// Navigation: physical swipe LEFT -> GPS (back, stays - both in the
// dock's GPS group). Physical swipe RIGHT -> Destinations (2026-09-22,
// re-added here after being removed in the styling/UX pass - see
// ui_event_navScreen()'s comment; Dyno LIVE is one swipe further from
// there, and still dock-reachable directly - see ui_dock.h's mapping
// comment). This board reports gesture direction inverted from the
// physical swipe (see CLAUDE.md's "Touch gesture direction") - the code
// checks LV_DIR_RIGHT for the physical-LEFT swipe and LV_DIR_LEFT for the
// physical-RIGHT swipe. Intentional; don't "fix" it without re-verifying
// on hardware first.
// ============================================================================

#include "ui.h"
#include "nav_reader.h"
#include "nav_map_render.h"
#include "router.h"
#include "nav_turn.h"
#include "gps_math.h"
#include "gps_driver.h"
#include "zombie_updaters.h"  // utcOffsetHours - see updateTurnGuidance()'s ETA calc
#include <math.h>
#include <esp_heap_caps.h>

lv_obj_t * ui_navScreen = NULL;

static lv_obj_t * ui_navTopBar = NULL;
lv_obj_t * ui_navClockLabel = NULL;
lv_obj_t * ui_navSocLabel = NULL;

static lv_obj_t * ui_navCanvas = NULL;
static lv_obj_t * ui_navTileLayer = NULL;  // map geometry - created before
                                             // the trail/here-dot below so
                                             // they always draw on top of it
static lv_obj_t * ui_navTrailLine = NULL;
static lv_obj_t * ui_navHereDot = NULL;
static lv_obj_t * ui_navScaleLabel = NULL;

static lv_obj_t * ui_navTurnBanner = NULL;
static lv_obj_t * ui_navTurnIconLabel = NULL;
static lv_obj_t * ui_navTurnDistLabel = NULL;

static lv_obj_t * ui_navStrip = NULL;
lv_obj_t * ui_navStatusLabel = NULL;
lv_obj_t * ui_navSpeedLabel = NULL;
lv_obj_t * ui_navHeadingLabel = NULL;
static lv_obj_t * ui_navEtaLabel = NULL;
static lv_obj_t * ui_navDistRemainingLabel = NULL;

// Persistent bottom nav dock (styling/UX pass Phase 5, 2026-09-18) - see
// ui_dock.h. GPS NAV is inside the GPS dock group (home screen: GPS).
static lv_obj_t * ui_navScreenDock = NULL;

// Swipe-nav position dots - purely decorative, this screen's own visual
// convention (no other screen in this project has this pattern yet).
// Matches the current 11-screen topology (CLAUDE.md's "Project overview"
// chain) - update NAV_TOPOLOGY_SCREEN_COUNT/THIS_INDEX together if a
// screen is ever added/removed from that chain.
#define NAV_TOPOLOGY_SCREEN_COUNT 11
#define NAV_TOPOLOGY_THIS_INDEX   8   // 0=Splash,1=Settings,2=Speed,3=Drive,
                                       // 4=Status,5=Battery,6=Charging,7=GPS,
                                       // 8=GPS NAV,9=Dyno LIVE,10=Dyno RESULTS
static lv_obj_t * ui_navDots[NAV_TOPOLOGY_SCREEN_COUNT];

#define TOPBAR_H 32
#define CANVAS_W 800
#define STRIP_H  90
// Shrunk by UI_DOCK_H (styling/UX pass Phase 5, 2026-09-18) to leave room
// for the persistent bottom nav dock - was a flat (480 - TOPBAR_H -
// STRIP_H), which used the full screen height with zero slack.
#define CANVAS_H (480 - TOPBAR_H - STRIP_H - UI_DOCK_H)

#define TRAIL_MAX_POINTS 120  // ~2 minutes of trail at the ~1Hz GPS fix rate
#define METERS_PER_DEG_LAT 111320.0
#define METERS_PER_PIXEL 3.0  // fixed scale - see header comment; not yet
                               // tuned against a real driving route

static double trailLat[TRAIL_MAX_POINTS];
static double trailLon[TRAIL_MAX_POINTS];
static int trailCount = 0;   // number of valid entries, caps at TRAIL_MAX_POINTS
static int trailHead = 0;    // index the NEXT point will be written to

static lv_point_t trailScreenPoints[TRAIL_MAX_POINTS];

// --- NAV vector tile rendering ---
#define NAV_TILE_ZOOM 16  // matches firmware/assets/gen_nav_fixture.py's
                           // fixture; real map data should target this
                           // zoom too until there's a reason to vary it

// RESOLVED 2026-09-20 - see nav_map_render.cpp's nav_map_render_line()
// comment for the full story: raising NAV_MAX_FEATURES_PER_TILE
// (nav_reader.h, 64->1024) to fix real per-tile DECODING surfaced a
// pre-existing hazard in the RENDER path instead - drawWideLine() (used
// for any LINESTRING/casing wider than 3px) could hang/reboot the board
// on a single occurrence, and a real tile is now guaranteed to include
// every wide-road feature it actually has (the old 64-feature cap just
// happened to get lucky and rarely/never decode one). Root-caused via
// per-feature Serial tracing on real hardware down to one specific
// feature (a widthPx=5 LINESTRING, last in a 233-feature tile) and fixed
// at the source in nav_map_render_line() (drawWideLine() no longer
// called at all). No render-time budget is needed anymore - every
// decoded feature (up to NAV_MAX_FEATURES_PER_TILE) is rendered.

// MULTI-TILE GRID (added 2026-09-20): a single NAV_TILE_ZOOM tile only
// covers ~513m across at this latitude (611.5m projected Mercator tile
// size * cos(33.06 deg)), while the canvas covers CANVAS_W*METERS_PER_PIXEL
// = 2400m across - a single loaded tile filled only a small, roughly
// centered patch of the screen ("I still only see a small map" - real
// user feedback, not a guess). Fix: load and render a grid of tiles
// around the vehicle instead of just one. Sized 5 wide x 2 tall rather
// than a symmetric NxN square:
// - Width (5 tiles = 2565m, centered on the vehicle's own tile: 2 tiles
//   each side) comfortably exceeds the 2400m canvas width with margin on
//   both edges regardless of the vehicle's exact position within its own
//   tile - this is the dimension that was badly undercovered (a single
//   tile's ~513m is only ~21% of the 2400m canvas width).
// - Height (2 tiles = 1026m: the vehicle's own tile + one neighbor,
//   asymmetric - only one side gets a full extra tile of margin) is a
//   deliberate compromise, not a full guarantee like width gets: a single
//   tile's ~513m already covered ~60% of the 858m canvas height (a much
//   smaller gap than width's 21%), so less additional coverage is needed
//   here, and the real constraint is PSRAM - see below.
// PSRAM: confirmed via ui_splash_truck.cpp's own boot-time
// heap_caps_get_free_size() log that only ~4.78MB PSRAM is free after
// splash preload (splash's own ~2.4MB of frame buffers are never freed -
// a separate, pre-existing inefficiency, not addressed here). At ~304KB
// per grid slot (NavTileData ~300KB dominates; gridFeatureObjs's
// NAV_MAX_FEATURES_PER_TILE pointers add ~4KB), a symmetric 5x3 (15
// tiles, ~4.56MB) would leave under 250KB free for GraphLoader's page
// cache (which needs up to ~960KB when routing - see graph_loader.h) -
// too tight, risking an allocation failure the instant "Home" is pressed
// while the full grid is loaded. 5x2 (10 tiles, ~3.04MB) leaves ~1.74MB
// free instead - comfortable margin for GraphLoader plus everything else.
//
// RESOLVED 2026-09-21, root cause found and fixed in
// nav_map_render.cpp::fillPolygonGeneral() - see that function's comment
// for the mechanism. Summary for anyone who finds the old investigation
// referenced elsewhere (git history, prior comments in this file): 5x2
// initially looked freeze-prone on real hardware in a way that survived
// disproving PSRAM/internal-RAM exhaustion, PSRAM-DMA bandwidth
// contention (a vTaskDelay(1) per-slot throttle, modeled on
// waveshareteam/ESP32-S3-Touch-LCD-5#1, did NOT fix it - removed again
// once the real cause was found), memory address/bank boundaries, and
// GPS-tick re-entrancy into repositionTileLayer(). Per-feature Serial
// tracing eventually caught it stalling inside fillPolygonGeneral()
// itself, on the first polygon in a whole 10-tile pass whose bounding
// box set a new maximum edgeBuckets size - a genuine memory-safety bug
// (stale linked-list data surviving a vector growth), not anything about
// PSRAM, timing, or this grid's dimensions. Confirmed stable at 5x2
// across multiple consecutive full render passes once fixed.
#define NAV_GRID_TILES_X 5
#define NAV_GRID_TILES_Y 2
#define NAV_GRID_TILE_COUNT (NAV_GRID_TILES_X * NAV_GRID_TILES_Y)

// One NavTileData + one LVGL-object-pointer array per grid slot, PSRAM-
// allocated by allocateNavBuffers() (called once, lazily, from the first
// ui_navScreen_screen_init()) - see nav_reader.h's sizing comment for why
// a single NavTileData can no longer be a plain static/global (~300KB at
// NAV_MAX_FEATURES_PER_TILE=1024). Allocated ONCE and kept for the
// firmware's lifetime rather than freed on every screen close/reopen
// (like nav_map_render's sprite is) - repeatedly alloc/freeing ~3MB
// across many screen visits over a real drive risks PSRAM fragmentation
// for no benefit.
static NavTileData * gridTiles[NAV_GRID_TILE_COUNT] = { nullptr };
static lv_obj_t ** gridFeatureObjs[NAV_GRID_TILE_COUNT] = { nullptr };
static bool gridSlotLoaded[NAV_GRID_TILE_COUNT] = { false };  // per-slot nav_tile_load() result - false is a legitimate "no data here" (e.g. open water), not an error

static bool gridLoaded = false;                 // whether loadGrid() has ever run
static uint32_t gridCenterTileX = 0, gridCenterTileY = 0;  // which tile the current grid is centered on

// Allocates every gridTiles[]/gridFeatureObjs[] slot above. Returns false
// (logged) if PSRAM is somehow already exhausted by something else -
// callers must treat that as "no map tile geometry available," same
// "degrade, don't crash" convention ui_splash_truck.cpp uses for its own
// PSRAM frame buffers, not a reason to abort screen init.
static bool allocateNavBuffers(void) {
    if (gridTiles[0]) return true;  // already allocated from an earlier call

    bool ok = true;
    for (int s = 0; s < NAV_GRID_TILE_COUNT; s++) {
        // calloc, not malloc: unlike the old single `static NavTileData`
        // (implicitly zero-initialized .bss), a PSRAM heap allocation is
        // NOT zeroed - featureCount must start at 0 so
        // repositionTileLayer()'s `for (i < tile->featureCount)` loop
        // can't ever iterate over uninitialized garbage before the first
        // real nav_tile_load() for that slot (possible: tile-load and
        // reposition/render are both pending-flag-serviced from loop()
        // independently - see ui_navScreen_processPendingTileLoad()/
        // ui_navScreen_processPendingReposition() - with no ordering
        // guarantee between them on a screen's first fix).
        gridTiles[s] = (NavTileData *)heap_caps_calloc(1, sizeof(NavTileData), MALLOC_CAP_SPIRAM);
        gridFeatureObjs[s] = (lv_obj_t **)heap_caps_calloc(
            NAV_MAX_FEATURES_PER_TILE, sizeof(lv_obj_t *), MALLOC_CAP_SPIRAM);
        if (!gridTiles[s] || !gridFeatureObjs[s]) ok = false;
    }

    if (!ok) {
#if defined(DEBUG) || defined(CAN_TRACE)
        Serial.println("[nav] PSRAM allocation failed for one or more grid tile buffers - map tile geometry may not fully render this session");
#endif
    }
    return ok;
}

// --- Routing (2026-09-22: generalized from "phone home" to an arbitrary
// destination - see ui_navScreen_requestRoute() below and
// ui_destinationsScreen.h for why: real bench use found a single Home
// button + "PRESS HOME" banner confusing and too much canvas real estate,
// so destination PICKING moved to its own screen (Home/Work/nearest
// charging station), while this file keeps owning the actual routing
// computation + turn-by-turn display. Still no address-entry/search UI -
// see this file's header comment for why that's out of scope, ever; the
// destination is always one of a small, fixed set chosen elsewhere, never
// typed in here.) ---
#define NAV_ROUTE_SPEED_KMH 60  // selects the CAR ROUTE.bin profile - see routeBinPath()

#define NAV_ROUTE_MAX_POINTS 300  // cap for on-screen route line drawing -
                                    // see this file's header comment; a
                                    // real A* route can be longer than
                                    // this, silently truncated same as
                                    // every other fixed-capacity buffer
                                    // in this project (not an error)
static int routePX[NAV_ROUTE_MAX_POINTS];
static int routePY[NAV_ROUTE_MAX_POINTS];

static TrackVector navRoute;
static TurnPointVector navTurns;
static NavState navState;
static bool routeComputePending = false;  // set by ui_navScreen_requestRoute(),
                                            // serviced from loop() - see
                                            // ui_navScreen_processPendingRoute()
static bool routeComputing = false;   // true from the request until
                                        // processPendingRoute() finishes -
                                        // lets updateTurnGuidance() show a
                                        // "ROUTING..." state instead of
                                        // "SELECT DESTINATION" during the
                                        // multi-second (sometimes 20+s, see
                                        // this file's header) blocking
                                        // computation
static double routeComputeLat = 0, routeComputeLon = 0;
static double routeDestLat = 0, routeDestLon = 0;  // target of the pending/active route - see ui_navScreen_requestRoute()

// RGB565 -> lv_color_t without assuming lv_color_t's internal union layout
// (LV_COLOR_DEPTH is 16 per include/lv_conf.h, but going through
// lv_color_make() rather than poking a union member keeps this correct
// even if that ever changes).
static lv_color_t navFeatureColor(uint16_t rgb565) {
    uint8_t r5 = (rgb565 >> 11) & 0x1F;
    uint8_t g6 = (rgb565 >> 5) & 0x3F;
    uint8_t b5 = rgb565 & 0x1F;
    return lv_color_make((r5 * 527 + 23) >> 6, (g6 * 259 + 33) >> 6, (b5 * 527 + 23) >> 6);
}

// Deletes every grid slot's LVGL objects (TEXT/POINT features) - called
// before a grid reload so a slot whose tile content changed (or that
// used to have data and now doesn't) doesn't leave stale objects behind.
static void clearGridFeatureObjs(void) {
    for (int s = 0; s < NAV_GRID_TILE_COUNT; s++) {
        lv_obj_t ** objs = gridFeatureObjs[s];
        if (!objs) continue;
        for (int i = 0; i < NAV_MAX_FEATURES_PER_TILE; i++) {
            if (objs[i]) {
                lv_obj_del(objs[i]);
                objs[i] = NULL;
            }
        }
    }
}

// Creates one LVGL object per decoded feature in gridTiles[slot] - called
// once per slot right after that slot's nav_tile_load() succeeds, not on
// every GPS fix. Screen position isn't set here; repositionTileLayer()
// does that every fix, same split as the trail's addPoint()/redrawTrail().
static void buildGridSlotLayer(int slot) {
    NavTileData * tile = gridTiles[slot];
    lv_obj_t ** objs = gridFeatureObjs[slot];
    if (!tile || !objs) return;  // PSRAM alloc failed - see allocateNavBuffers()
    for (uint16_t i = 0; i < tile->featureCount; i++) {
        NavFeature *f = &tile->features[i];
        lv_color_t color = navFeatureColor(f->colorRgb565);

        if (f->geomType == NAV_GEOM_TEXT) {
            lv_obj_t * label = lv_label_create(ui_navTileLayer);
            lv_label_set_text(label, f->text);
            lv_obj_set_style_text_color(label, color, LV_PART_MAIN | LV_STATE_DEFAULT);
            lv_obj_set_style_text_font(label, &font_montserrat_extrabold_16, LV_PART_MAIN | LV_STATE_DEFAULT);
            if (f->shieldBgRgb565 != 0) {
                lv_obj_set_style_bg_color(label, navFeatureColor(f->shieldBgRgb565), LV_PART_MAIN | LV_STATE_DEFAULT);
                lv_obj_set_style_bg_opa(label, 255, LV_PART_MAIN | LV_STATE_DEFAULT);
                lv_obj_set_style_border_color(label, navFeatureColor(f->shieldBorderRgb565), LV_PART_MAIN | LV_STATE_DEFAULT);
                lv_obj_set_style_border_width(label, 1, LV_PART_MAIN | LV_STATE_DEFAULT);
                lv_obj_set_style_pad_all(label, 2, LV_PART_MAIN | LV_STATE_DEFAULT);
            }
            objs[i] = label;
        } else if (f->geomType == NAV_GEOM_POINT) {
            lv_obj_t * dot = lv_obj_create(ui_navTileLayer);
            lv_obj_clear_flag(dot, LV_OBJ_FLAG_SCROLLABLE | LV_OBJ_FLAG_CLICKABLE);
            lv_obj_set_size(dot, 8, 8);
            lv_obj_set_style_radius(dot, LV_RADIUS_CIRCLE, LV_PART_MAIN | LV_STATE_DEFAULT);
            lv_obj_set_style_bg_color(dot, color, LV_PART_MAIN | LV_STATE_DEFAULT);
            lv_obj_set_style_bg_opa(dot, 255, LV_PART_MAIN | LV_STATE_DEFAULT);
            lv_obj_set_style_border_width(dot, 0, LV_PART_MAIN | LV_STATE_DEFAULT);
            objs[i] = dot;
        } else {
            // LINESTRING or POLYGON - rendered into nav_map_render's
            // raster sprite instead of an lv_obj (see file header); no
            // LVGL object needed, objs[i] stays NULL so
            // repositionTileLayer() knows to route this feature there.
            objs[i] = NULL;
        }
    }
}
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
