robertwa1974/evScout--dash/firmware/src/ui_inclineScreen.cpp

// ============================================================================
// ui_inclineScreen.cpp - inclinometer: pitch and roll, degrees
// ============================================================================
// Hand-written (2026-10-29). Two side-by-side 388x392 panels above the dock:
//   left  PITCH - Scout side view (nose right), tilts with pitch
//   right ROLL  - Scout end-on view, tilts with roll. Drawn from the FRONT
//                 render (the truck is near-symmetric end-on), but the angle
//                 is applied as if seen from behind: the driver's left is on
//                 screen left, so LEANING LEFT tips the picture left.
// Each: an lv_meter used for its +-45 degree tick scale and amber/red zone
// arcs only (labels rewritten to absolute values in a draw-part callback) -
// no meter needle, since a needle from the centre would cut through the
// truck; the pointer is a short lv_line at the arc instead.
//
// Truck artwork: wireframes hand-traced from renders of the actual truck
// (firmware/assets/convert_incline_art.py), stored as packed outline/detail
// coverage masks (img_incline_scout.h). expandArt() turns each into an
// LV_IMG_CF_TRUE_COLOR_ALPHA buffer in PSRAM in the current palette's
// colours (outline = text primary, detail = text secondary) - redone on a
// day/night switch - and lv_img_set_angle() rotates it. LVGL 8.4's software
// transform only handles TRUE_COLOR*/RGB565A8, which is why the colours are
// baked here rather than recoloured at draw time.
//
// Angles: imu_get_attitude() - complementary filter in the IMU task, see
// imu_driver.h for how launch/brake and cornering are subtracted. Zones:
// amber from 75% of warningSet.pitchDeg/rollDeg, red at them. Those are
// user-tuned starting points, not rollover limits - the user manual says so.
//
// Never falls back to raw chip axes (CLAUDE.md, IMU level): no IMU or no
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
