robertwa1974/evScout--dash/(commit log)

2026-09-15 Initial import: Scout 80 EV dashboard, rebuilt from Light-r4y/uaDASH
    Retargets the original rusEFI CAN dashboard firmware to a Scout 80 EV
    running a ZombieVerter VCU (CANopen SDO + broadcast decode), on the same
    Waveshare ESP32-S3-Touch-LCD-7 hardware. Every screen, driver, and font
    asset has been rewritten from scratch for this vehicle and this display;
    the only material carried over from upstream is the target hardware
    choice and the physical connector/enclosure design (see LICENSE and
    CLAUDE.md for MIT attribution to Light-r4y/uaDASH, kept as the `upstream`
    git remote rather than a GitHub fork, since essentially none of the
    original firmware source survives unchanged).
    Highlights (full m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
    [zombieverter_replay.csv]
2026-09-15 Fix test_nav_tile: link src/ for the test, guard firmware.ino under UNIT_TEST, fix stack-overflow boot loop
    First real run of test_nav_tile against the SD card + fixture surfaced three
    issues once hardware was available to test against: PlatformIO's test
    runner doesn't link project src/ by default (needed for sd_driver.cpp/
    nav_tile_reader.cpp), which collided with firmware.ino's setup()/loop()
    once fixed, and the test never called lcd_panel_start()/sd_init() itself.
    Also fixes a real bug: test_out_of_bounds_tile_is_absent declared a ~12KB
    NavTileData as a stack local, overflowing the task stack and silently
    boot-looping the board with no serial output.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
    [firmware.ino]
2026-09-15 Render NAV vector tiles onto the GPS NAV screen, verified on real hardware
    ui_navScreen.c now draws whatever tile covers the vehicle's position,
    reusing the breadcrumb trail's existing flat-earth-meters projection so
    map geometry and the trail draw in one consistent coordinate system.
    Added nav_latlon_to_tile()/nav_tile_local_to_latlon() (standard Web
    Mercator slippy-map math) to nav_tile_reader.{h,cpp} to convert between
    GPS fixes and this format's tile numbering/local vertex space. SD reads
    only happen on a tile crossing; repositioning already-built LVGL objects
    happens every GPS fix, same split as the trail's own addPoint()/
    redrawTrail(). First pass is deliberately simple: only a polygon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
    [nav_tile_reader.h, ui_navScreen.c]
2026-09-15 Fix task-watchdog crash rendering real NAV tile data, split large files by region
    Relocating [env:mock-gps]'s canned route into real San Francisco (to
    visually verify real map rendering, not just check nav_tile_load()
    succeeds) crash-looped the board every time the GPS NAV screen opened.
    Two real fixes, only the second of which actually resolved the crash:
    - Split large single-zoom .nav files into a grid of smaller regional
    files (NAV_REGION_TILES=64 in nav_tile_format.h, own scheme on top of
    Tile-Generator's format, not part of it) via the new
    firmware/assets/split_nav_file.py, since the Arduino ESP32 SD library's
    seek() measured roughly O(distance) on a single large file (a seek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
    [firmware.ino, gps_mock_source.cpp, nav_tile_format.h, ui_navScreen.c, ui_navScreen.h]
2026-09-16 Port jgauchia/IceNav-v3's Router/A*/GraphLoader routing engine
    Component 2 of adopting IceNav-v3's actual code for the GPS NAV screen
    (pinned tag v.0.2.9, commit d1819b771e12394e185cdf18e8a14875b0998912).
    Adds router.h/.cpp, graph_loader.h/.cpp, astar.h/.cpp, route_types.h, and
    psram_allocator.h, ported close to verbatim - class/function names,
    LRU page-cache algorithm, and A* tuning constants unchanged from
    upstream, confirmed against its route_types.hpp byte-for-byte (the
    requirements doc's ROUTE.bin description was accurate, unlike its NAV
    tile format description - see nav_reader.h's earlier correction).
    Three deliberate deviations, each documented in the relevant file's
    header comment: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
    [astar.cpp, astar.h, graph_loader.cpp, graph_loader.h, psram_allocator.h, route_types.h, router.cpp, router.h]
2026-09-16 Port jgauchia/IceNav-v3's polygon-fill map renderer, wire it into GPS NAV
    Adds nav_map_render.{h,cpp}: a trimmed port of maps.cpp's
    fillPolygonGeneral() (scanline Active-Edge-List fill with ring/hole
    support, pinned tag v.0.2.9, commit
    d1819b771e12394e185cdf18e8a14875b0998912) targeting a LovyanGFX
    LGFX_Sprite wrapped as an lv_img, replacing the outline-only lv_line
    approach ui_navScreen.c used for LINESTRING/POLYGON features. Point and
    text features stay LVGL objects overlaid on top - only geometry that
    benefits from real fills/holes moved to the raster path.
    Two deliberate deviations from upstream, both documented in
    nav_map_render.cpp's header comment:
    - The sprite is created with lgfx::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
2026-09-16 Fix GPS NAV screen freeze: avoid anti-aliased line draws for thin roads
    nav_map_render_line() was calling LovyanGFX's drawWideLine() (an
    anti-aliased wedge rasterizer) for every LINESTRING segment on every GPS
    fix, doubled again for casing. A real tile can have a few hundred such
    segments, and the combined cost - all running inside the same
    uiMutex-guarded block touch handling also needs - made the GPS NAV screen
    effectively freeze on real hardware (confirmed: other tasks kept running,
    but touch input stopped being serviced for the whole render). Only roads
    wider than 3px now use drawWideLine(); everything else uses plain
    drawLine() (cheap Bresenham, no AA), which is the overwhelming majorit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
    [nav_map_render.cpp]
2026-09-16 Port jgauchia/IceNav-v3's turn-by-turn guidance logic (Component 4)
    Adds gps_math.{h,cpp} (calcDist/calcDistSq/calcCourse/calcAngleDiff,
    ported from lib/utils/src/gpsMath.{hpp,cpp}, LUT-optimized trig path
    dropped - not worth it at this call volume, ~1Hz against a route's worth
    of points) and nav_turn.{h,cpp} (TurnPoint/NavState/NavConfig,
    nav_turn_detect() ported from GPXParser::getTurnPointsSlidingWindow(),
    findClosestTrackPoint()/advanceTurnIndex()/findNextValidTurn()/
    projectOnSegment() ported from navigation.cpp), all pinned tag v.0.2.9,
    commit d1819b771e12394e185cdf18e8a14875b0998912.
    evaluateTurnGuidance() adapts updateNavigation()'s decision logic (closest-
    point projection, off-tra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
2026-09-16 Build new GPS NAV screen UI wiring routing + turn guidance + map render (Component 5)
    Replaces ui_navScreen.c's breadcrumb-only layout with the full mockup:
    top status bar (time + SOC%), turn-instruction banner (new baked
    font_turn_icons_48 icon set: straight/left/right/sharp-left/sharp-right/
    flag), map canvas with route line overlay (Router::route() against a
    hardcoded test destination for v1 - no destination-entry UI yet), and a
    reorganized two-row telemetry strip (status/speed/heading, then ETA/
    distance-remaining/screen-position dots).
    Router::route() and nav_tile_load() both block on SD I/O, so route
    computation is serviced from firmware.ino's loop() via the same
    pending-flag pattern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
    [firmware.ino, ui_navScreen.cpp, ui_navScreen.h, zombie_updaters.cpp]
2026-09-17 Fix two real-hardware crashes surfaced by end-to-end routing (Component 5)
    Generated a real California ROUTE.bin (route_generator, all 3 profiles)
    and copied CAR onto the SD card to exercise Router::route() for the
    first time against real data instead of the "NO ROUTE" fallback path.
    This immediately surfaced two crashes:
    1. GraphLoader::cellIndex_ used the plain default allocator (internal
    SRAM) instead of PsramAllocator like the rest of this class. Fine for
    upstream's own small test extracts, but California's whole-state CAR
    graph has 15928 cells (~311KB just for the index), enough to exhaust
    internal heap already under pressure from LVGL's draw buffers/WiFi/
    BT/task stacks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
    [graph_loader.h, ui_navScreen.cpp]
2026-09-18 Add "phone home" button to GPS NAV screen; drop general-destination routing
    Scope narrowed per explicit request: not general navigation-to-anywhere,
    just a single button that routes back to one fixed home address (1377
    Calle Scott, Encinitas, CA 92024, geocoded via OSM Nominatim). Destination
    entry UI is no longer a deferred gap - it's out of scope entirely.
    Routing is now button-triggered (ui_event_navHomeBtn), not computed
    automatically on screen open, so idle glances at the GPS NAV screen don't
    pay for an unwanted route computation.
    Two real hardware bugs found and fixed while wiring this up, both via a
    decoded touch-event trace, not guesswork:
    - The button was originally 26px tall in t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
    [gps_mock_source.cpp, ui_navScreen.cpp, ui_navScreen.h]
2026-09-20 Add splash-screen truck-revolve animation; fix real-hardware CAN/12V bugs
    Adds a turntable truck-revolve animation to the splash/clock screen's
    CAN-arrival/timeout hold: convert_splash_frames.py bakes 22 turntable PNGs
    into raw LVGL RGB565 frames on the SD card, ui_splash_truck.cpp preloads
    them into PSRAM on a background task and plays them via a custom lv_fs
    driver (lv_fs_sd.cpp) with per-frame SD fallback for anything not yet
    cached, so playback never blocks on slow SD reads or holds up the wipe
    reveal.
    Fixes found through real-hardware CAN/12V bench testing:
    - Task watchdog trip during preload (tight SD read loop starved IDLE0 on
    core 0) - fixed with a per-frame vTaskDelay(1).
    - Truck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
    [firmware.ino, lv_fs_sd.cpp, lv_fs_sd.h, mutex.cpp, sd_driver.cpp]
2026-09-20 Fix truck-revolve visual quality: fill screen, smooth playback, clean bg
    Three real-hardware-driven fixes on top of the truck-revolve splash
    animation, following user feedback after visually confirming each one:
    - Fill the screen: native frame size dropped from an earlier 480x480
    (which didn't all fit in PSRAM and made SD reads slow) to 240x240,
    displayed at 480x480 via LVGL zoom instead of by reading bigger files -
    keeps preload fast (~7s for all 22 frames, all fitting in PSRAM) while
    still filling the panel's full height on screen.
    - Smooth playback: LVGL's built-in TRUE_COLOR file decoder streams a
    fallback frame's pixels row-by-row live off SD during the draw call
    itself, s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
    [ui_splashScreen.cpp, ui_splash_truck.cpp, ui_splash_truck.h]
2026-09-23 Add Destinations screen, WiFi config page, imperial units; fix GPS NAV grid freeze and pill click-through bugs
    Real hardware bugs found and fixed:
    - GPS NAV multi-tile grid freeze (days-long investigation): edgeBuckets in
    nav_map_render.cpp grew via resize() without clearing pre-existing slots,
    leaving stale pool indices that could chain into a cycle and spin forever.
    Fix is a straight unconditional bucket reset per fill.
    - gps_driver.cpp: hasFix was driven off TinyGPSPlus's isUpdated() (a
    per-poll-cycle flag), flickering true/false on pure polling-cadence noise
    even with a rock-solid fix. Switched to isValid()+age() staleness check.
    - ui_status_pill.cpp: every status pill was clic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
    [charging_stations.cpp, charging_stations.h, firmware.ino, gps_driver.cpp, imu_driver.cpp, nav_map_render.cpp, nav_reader.h]
2026-09-26 Split Settings into sub-pages, fix speedometer tick labels, set 120mph limit
    Settings was one continuously-scrolling lv_menu page with all three
    sections stacked; restructured into a top-level list (Warning Thresholds /
    Display / Calibration) that each navigate into their own page via lv_menu's
    built-in back-button/history mechanism, eliminating the scroll. Also
    shrank the threshold rows (buttons to CLAUDE.md's 80px floor, smaller
    spinbox font) since they read as oversized. Confirmed warning thresholds
    already work correctly (feed the fault banner and Status/Battery
    warn-coloring) - no logic changes there.
    Speedometer never had its tick-number labels verified on real hardware -
    root cause w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
    [ui_settingsScreen.cpp, ui_speedScreen.c]
2026-10-12 Updating enclosure files
2026-10-22 Add cluster home screen, VCU parameter tools, SD logging, odometer
    Home screen rebuilt as a twin-binnacle cluster: 400px speedometer with
    odometer and trip readouts, P R N D strip, SOC and motor-temp needle
    gauges, and power/pack V/pack A/12V cards. Odometer integrates Veh_Speed
    (GPS fallback) and persists to NVS once per mile and on low-12V shutdown.
    New Settings pages: VCU Parameters (SDO read/write of curated tunables
    plus save to VCU flash), Diagnostics (~40 raw spot values), and Data
    Logging (CSV to /logs on the SD card). On-demand SDO goes through
    sdo_client, which shares the main poll slot and enforces a per-param
    write interlock.
    Drive screen: Gear, Motor Mode, Regen Limit and new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
2026-10-23 Add CAN Monitor page with decoding, baseline and SavvyCAN capture
    Settings > CAN Monitor, for checking the dash's own bus setup and new
    devices (full decoding stays in SavvyCAN on the bench):
    - per-ID summary (name, rate, data with changed-byte highlighting) and a
    bus health line (state, frames/s, load estimate, TEC/REC, missed)
    - light decoding of VCU SDO replies, IVT-S (little-endian, scaled as the
    ZombieVerter's isa_shunt/utils code does) and SimpBMS frames, plus a
    shunt-vs-VCU current/voltage cross-check
    - known-good baseline saved to NVS, flagging NEW / MISSING / RATE
    - raw capture to /can/CANnnnn.csv in SavvyCAN native CSV format,
    including the dash's own SDO requests as Tx; do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
2026-10-24 Fix CAN capture crashes: PSRAM LVGL allocator, table shrink, open-file limit
    - LVGL allocated widgets with plain malloc, which the Arduino core serves
    from internal RAM; opening Settings left ~2KB and the next fopen()
    aborted in newlib (CAN capture start rebooted the dash). LVGL now
    allocates PSRAM-first via include/lv_psram_alloc.h; internal free holds
    ~57KB with WiFi on.
    - LVGL 8.4's lv_table_set_row_cnt() dereferences never-assigned cells when
    shrinking; the CAN Monitor's empty FLAG cells crashed it on page
    re-entry. New rows now get every cell assigned.
    - SD max open files raised from 5 to 10 - log, capture, nav region file,
    route graph, LVGL image and a web download can al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
2026-10-24 Restyle hotspot web pages; remove upstream leftovers
    Web pages (Config / Live / Logs): shared dark theme in the dash's own
    palette served once from /style.css, sticky header with tab nav, card
    layout. Config gets labelled fields with units, a Saved banner and a
    locked-while-moving banner; Live becomes grouped tiles with an SOC bar,
    cell spread, CAN status pill and update age; Logs gets sized file rows
    with Download buttons, delete confirmation and a RECORDING badge. Pages
    and /api/live are sent no-store so a firmware update shows up at once.
    All self-hosted - the hotspot has no internet.
    Cleanup of material inherited from the upstream fork:
    - remove release/ (rusEFI dash5 arduino-cli flashe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
2026-10-24 Update enclosure design: board box, lid, tray and clamp bars
2026-10-24 Fix Low Pack Voltage stepper showing 2.802 instead of 280.2
    lv_spinbox_set_digit_format()'s second argument is the number of digits
    before the decimal point, not the number of decimals - the row passed 1.
    Renamed the helper's parameter to intDigits and documented it. Also marks
    the SDO save-to-flash command as verified on Rob's ZombieVerter, and
    resets DASH_TAG to DEV after the v2.0 release.
2026-10-24 Add efficiency (Wh/mi) and range estimate
    odometer.h now integrates energy from the VCU's power over measured
    distance (CAN live, not charging, moving or within 60 s of moving):
    trip, recent (~10 mi in 0.2 mi segments) and lifetime Wh/mi, and range
    = SOC x BattCap / recent Wh/mi. BattCap (param 38) joins the poll table.
    Home screen: RANGE card replaces PACK V; TRIP caption shows the trip's
    Wh/mi. Phone Live page gains an Efficiency card; CSV logs gain
    trip_whmi / recent_whmi columns.
2026-10-24 Logging waits for the VCU; Delete all buttons on /logs
    Data logging is now armed rather than always-on: with the switch on, no
    file is created until CAN is live and the VCU leaves Off, so bench boots
    with the VCU off no longer leave empty logs. Once started, a file runs
    until power-off. A card write failure disarms it (not persisted) so it
    can't spawn a new file every loop.
    The /logs page gains a confirmed Delete all button per folder (telemetry
    logs, CAN captures); files still recording are kept, and it's drive-locked
    like single delete.
2026-10-24 Add firmware update over WiFi (/update)
    New Update tab on the hotspot pages: upload firmware.bin with a progress
    bar; it's written to the inactive OTA slot (app0/app1 - no partition
    change needed), verified by ESP-IDF, then the dash flushes logs/captures,
    saves the odometer and reboots into it. Settings are kept.
    Guards: drive lock, and the first chunk must carry the app description
    magic (0xABCD5432 at offset 32) - this rejects the merged release image,
    whose leading bootloader would otherwise look like a valid ESP image.
2026-10-24 Save odometer when the vehicle stops, and every 0.25 mi
    For ignition-switched power, where key-off cuts power with no warning:
    the odometer/trip/efficiency totals are now saved 3 s after the vehicle
    stops (if it moved at least 10 m since the last save) and every 0.25 mi
    while moving, instead of once per mile.
2026-10-24 Compute road speed from motor rpm with GPS calibration
    The VCU's Veh_Speed is never set with Vehicle = Classic (only the BMW
    vehicle classes write it), so speedometer, odometer, efficiency, dyno and
    the drive locks all read 0. The dash now computes road speed as
    |motor rpm| x K, with one K per LS600h MG2 range picked from GearFB (2047,
    now polled); motor rpm is also polled every 4th slot (~200ms).
    Settings > Calibration gains axle ratio and tire diameter steppers, a live
    range/rpm/speed readout and CALIBRATE FROM GPS, which averages GPS speed /
    motor rpm over 20 s of steady 25+ mph driving and stores K for the engaged
    range (rejecting unsteady or implausible results). Until calibrated, K
    as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
2026-10-24 Use ORNL LS600h range ratios; add transfer case ratio setting
    Speed estimates now use the MG2 range reductions from ORNL/TM-2008/185
    (2008 LS 600h teardown): LOW 3.90:1 (from tooth counts), HIGH ~1.9:1,
    instead of a 1.00:1 placeholder - so uncalibrated speed is within a few
    percent rather than 2-4x high. New transfer case ratio setting (default
    1.00, the LS600h case being a centre diff) on the Calibration page and
    phone Config page, for other drivetrains.
    Uncalibrated ranges are always derived from current settings rather than
    read back from NVS, so the corrected defaults reach already-flashed
    dashes. GPS calibration now rejects results >25% off the nominal ratio
    with a message naming the l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
2026-10-24 Stop VCU canmap broadcasts overwriting SDO telemetry
    Rob's VCU sends canmap frames (0x355/0x356/0x126/0x210/0x257) at 10 Hz.
    The dash decoded them with the gain inverted (the VCU sends value x gain)
    and wrote them over the SDO values every 100 ms: udc 366 V showed as
    3.2 V, U12V 14.3 V as 0.09 V, plus coarse motor rpm. Every one of those
    params is already SDO-polled at full resolution, so broadcasts are now
    decoded for the trace only. Found via the CAN Monitor shunt-vs-VCU check.
2026-10-25 Bring docs and stale code comments up to date with v2.2.1
    USER_MANUAL.md rewritten for the current firmware: cluster home screen,
    road-speed calibration, odometer/trip/range, Drive-screen editors, VCU
    Parameters, Diagnostics, CAN Monitor, Data Logging, WiFi pages and
    firmware update. Build log and architecture doc now record what is built
    and what is still open, instead of the original "next milestones".
    README home-screen line lists RANGE, not pack V.
    Also corrects GPS wiring (UART0 shared with USB, not UART1), the CAN
    section (all-SDO, broadcasts trace-only), the screen count (12), and
    code comments that still called Auto day/night, the dyno screens and the
    offline map unbuilt.
    Co-Author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
2026-10-25 Add 1-click web installer and tagged GitHub Releases
    web-flasher/ (ESP Web Tools page + manifest) is deployed to gh-pages by
    the new web-flasher workflow on every v* tag or manual run. The manifest
    writes bootloader, partitions, boot_app0 and the app as separate parts
    instead of one merged factory.bin: a merged image fills the NVS gap at
    0x9000 with 0xFF and would wipe settings, speed calibration and the
    odometer on every install. boot_app0 resets otadata so the board boots
    the new app0 even after a WiFi update left it on app1.
    Tags also create a GitHub Release with firmware.bin (for the WiFi
    /update page) and a -full.bin merged image for blank boards. The
    workflow refuses a tag that doesn'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
2026-10-25 Add SD card guide and keep the Tile-Generator Windows patches
    SD_CARD.md documents what goes on the microSD card (map tiles, CAR
    routing graph, charging stations, splash frames), how to set up a new
    card, and how to regenerate each dataset. Linked from the README and
    the manual's troubleshooting table.
    The two Windows portability patches Tile-Generator needs (sys/mman.h
    shim, ftruncate -> _chsize_s) only existed in a local clone; copies are
    now in firmware/assets/tilegen-windows/.
    sd_driver.h's path index now lists the routing and charging files.
2026-10-30 Enclosure v8: bolt-down board box with SMA bulkhead, front-lip relief
    - Case: front-lip relief for the glass recess, 4 captive-nut bosses
    inside the floor so the board box bolts on instead of VHB.
    - Box (v8): mirrored layout (GPS right, IMU left), cable bay with an SMA
    bulkhead, wire windows in both bay side walls, 4 bolt-down feet.
    - Lid now 4x M3 self-tapping.
    - Regenerated STLs and views; v7/v8 box renders added.
2026-10-30 Add Incline screen, IMU level calibration and wireframe splash frames
    Incline screen (between Drive and Status):
    - Pitch and roll in degrees, each a rotated wireframe of the truck over a
    +-45 deg tick arc with amber/red zones from new High Pitch / High Roll
    warning thresholds.
    - imu_get_attitude(): complementary filter in the IMU task that subtracts
    d(road speed)/dt and speed x yaw rate, so launches and turns don't read
    as hills or lean. "UNCORRECTED" only when the IMU sees motion and there's
    no speed source.
    - Wireframes hand-traced from renders of the truck
    (convert_incline_art.py), expanded at runtime into PSRAM images in the
    current day/night palette.
    IMU level calibration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
2026-10-31 Incline: show roll as a rear view of the truck
    The ROLL panel used a front view while applying roll as seen from behind
    (driver's left on screen left). From the front the sides are mirrored, so
    the picture read as leaning the opposite way to the caption. Traced a rear
    view (tailgate, taillights, rear window, bumper, roof rack) in the same D2
    style from the rear render and switched the panel to it - the picture,
    caption and driver's sense of left/right now agree. Confirmed on hardware.
2026-11-01 Destinations: side-by-side Home/Work cards, larger charging list
    Stacked 784x124 Home/Work rows left the charging list a 128px window,
    under one full row. Home and Work are now 388x92 cards side by side, the
    "nearest stations" header stays fixed, and the five 84px rows scroll in
    264px (about 2.9 visible). Long names end in "..." instead of reaching
    the chevron. refresh_theme now repaints row titles, chevrons and the
    header, which a day/night switch used to miss. Confirmed on hardware.
